DalinYYYY/JM-App/User/DataHub/version_readme.md

# 版本记录

> 版本号定义见 `User/DataHub/version.h`。每次主仓库提交递增 `APP_VERSION_PATCH`，并在下表追加对应条目。

| 版本 | 日期 | 类型 | 备注 |
| --- | --- | --- | --- |
| 1.0.0 | 2026-09-18 | baseline | 现有基线版本发布 |
