DalinYYYY/JM-App/User/Data/picture/重构后过渡模块边界图.jpg

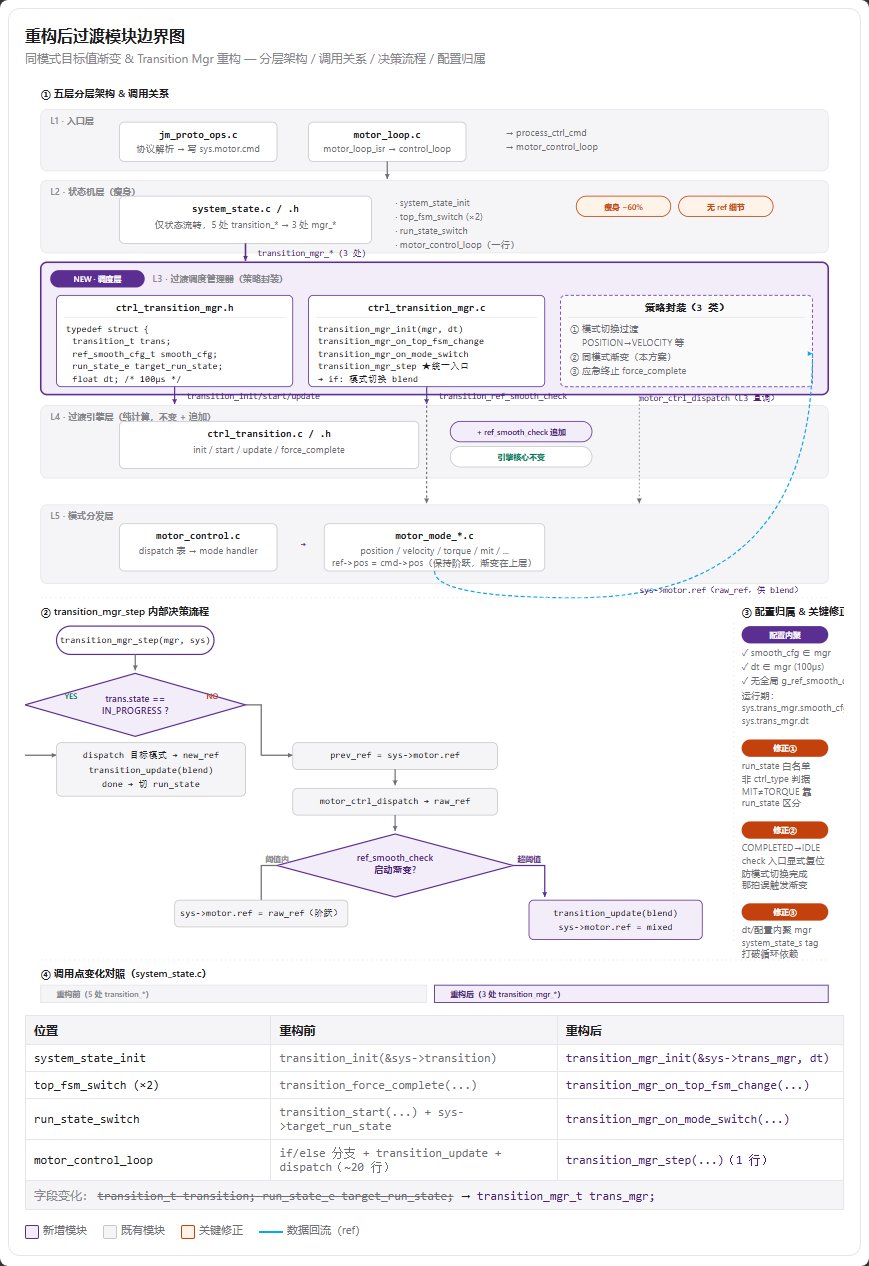
User/Data/picture/重构后过渡模块边界图.jpg
