DalinYYYY/JM-App/User/MotorAlgorithms/docs/开环速度观测对比.jpg

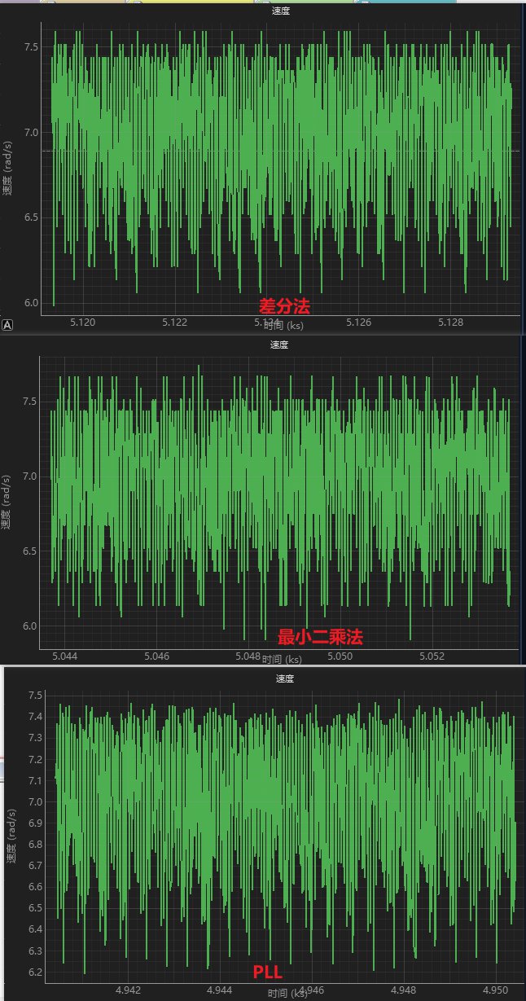
User/MotorAlgorithms/docs/开环速度观测对比.jpg
