DalinYYYY/JM-App/User/Data/docs/SCH_FOC_SCH_V1.0_2026-07-20.pdf

框架：

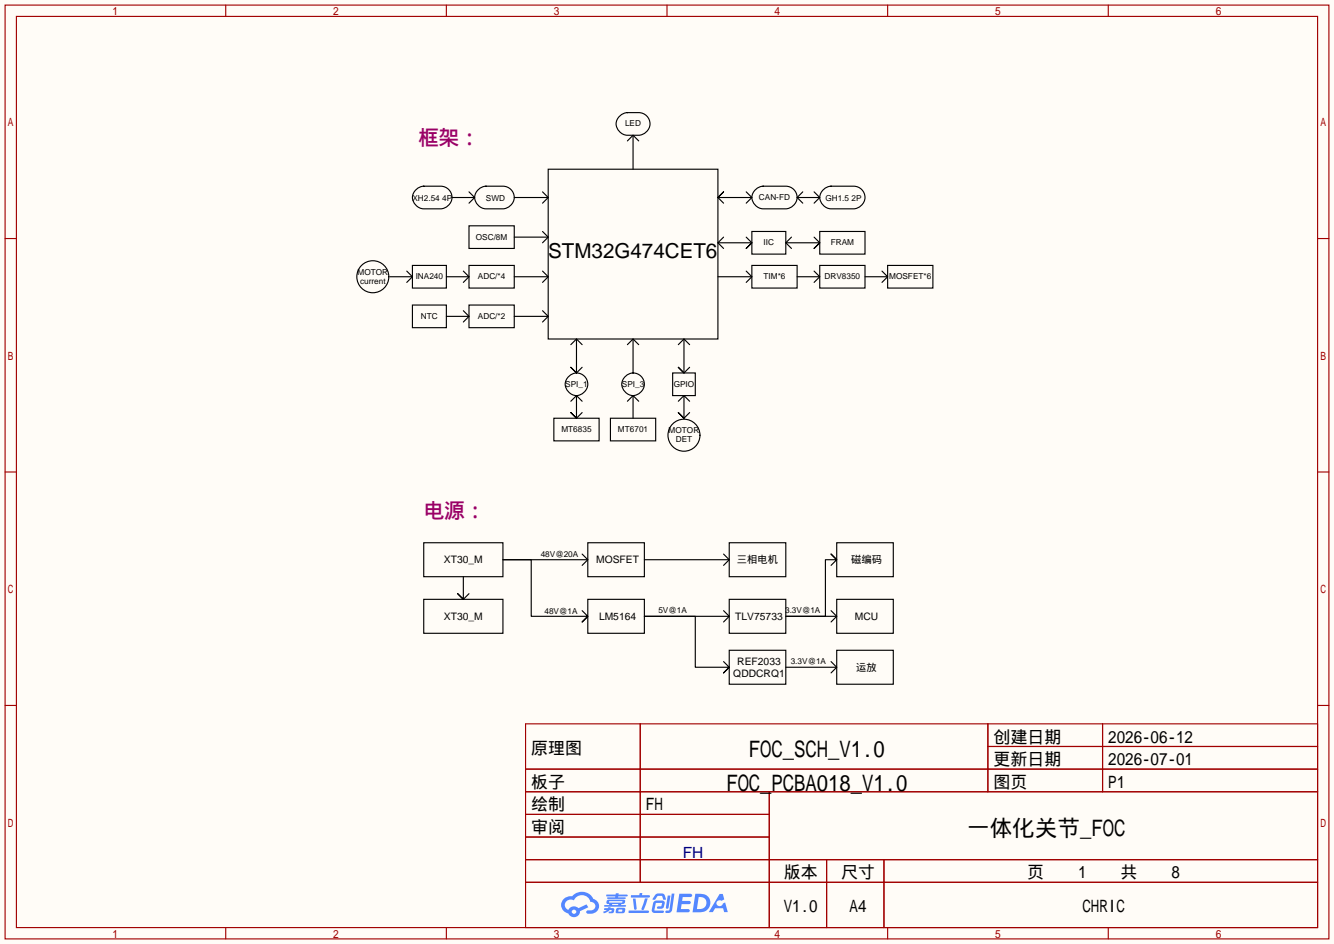
[picture p7: page 1]

原理图 | FOC_SCH_V1.0 | 创建日期 | 2026-06-12
板子 | FOC_PCBA018_V1.0 | 图页 | P1
绘制 | FH | 一体化关节_FOC
审阅

更新日期 | 2026-07-01

V1.0 | A4 | CHRIC

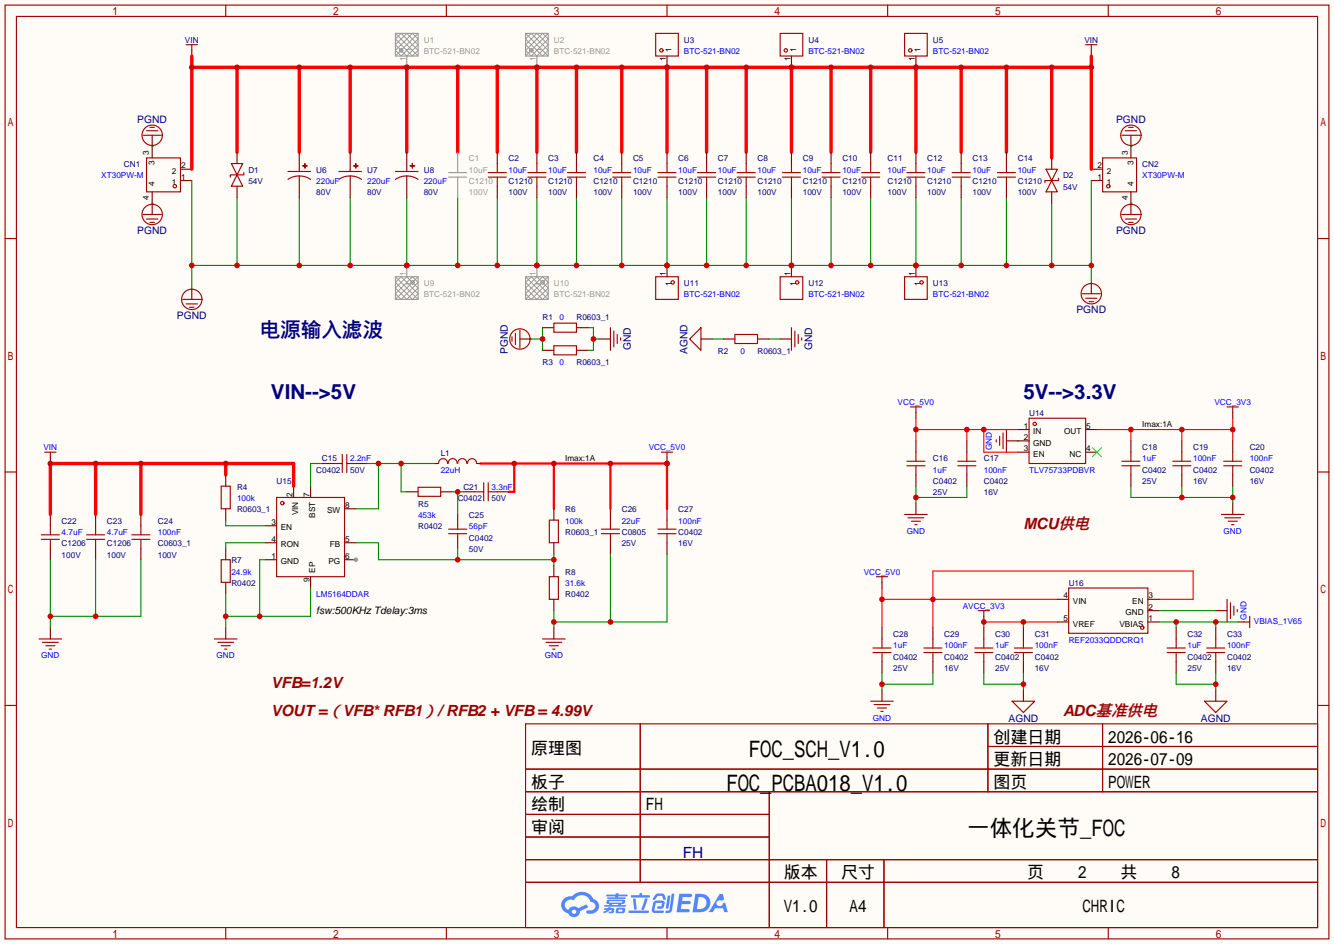
[picture p8: page 2]

原理图 | FOC_SCH_V1.0 | 创建日期 | 2026-06-16
板子 | FOC_PCBA018_V1.0 | 图页 | POWER
绘制 | FH | 一体化关节_FOC
审阅

更新日期 | 2026-07-09

晶振 | MCU | LED

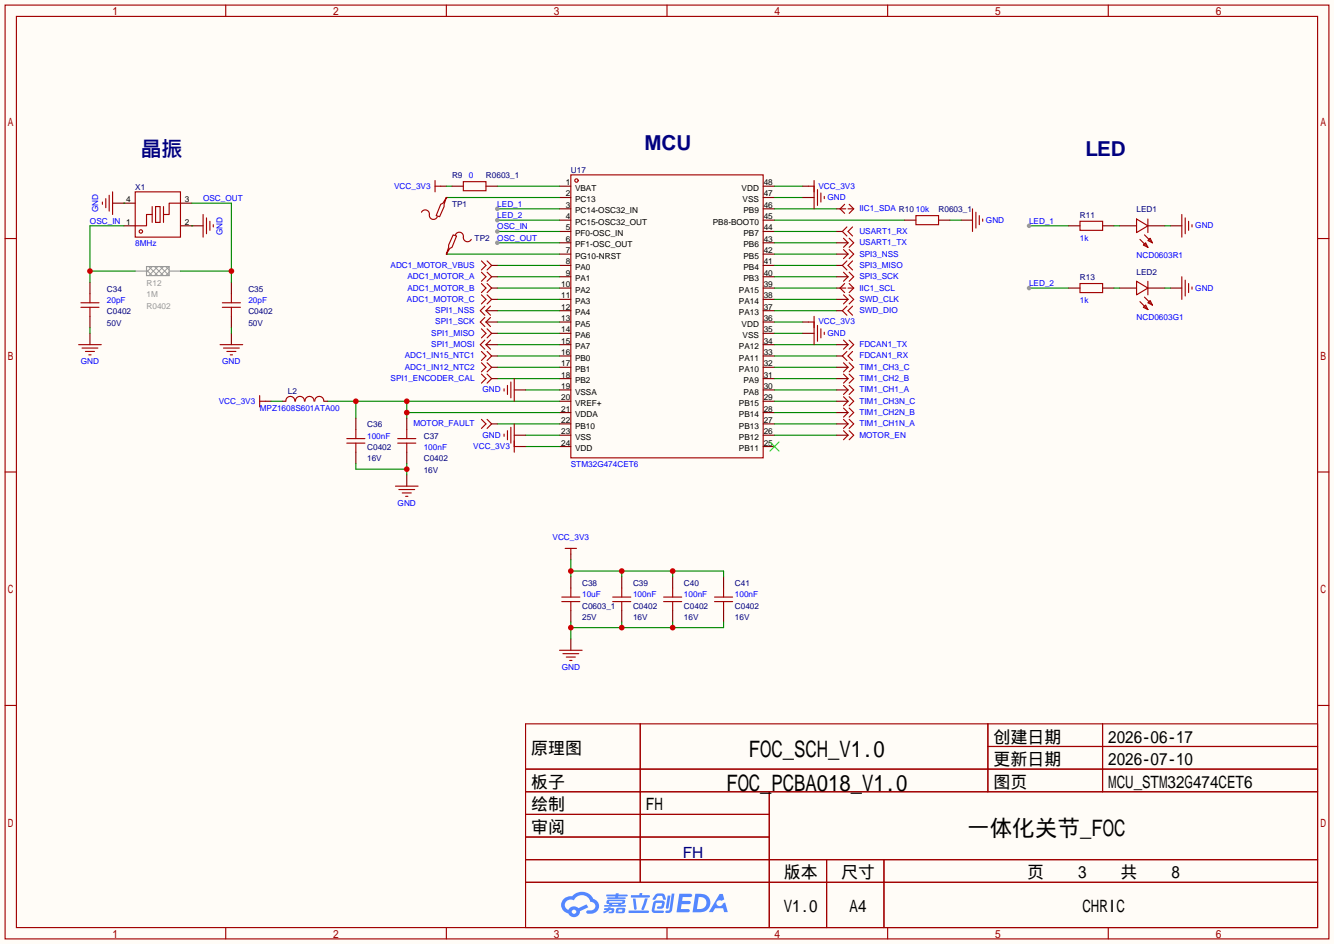
[picture p9: page 3]

原理图 | FOC_SCH_V1.0 | 创建日期 | 2026-06-17

更新日期 | 2026-07-10

板子 | FOC_PCBA018_V1.0 | 图页 | MCU_STM32G474CET6
绘制 | FH | 一体化关节_FOC
审阅

主编码 | 副编码

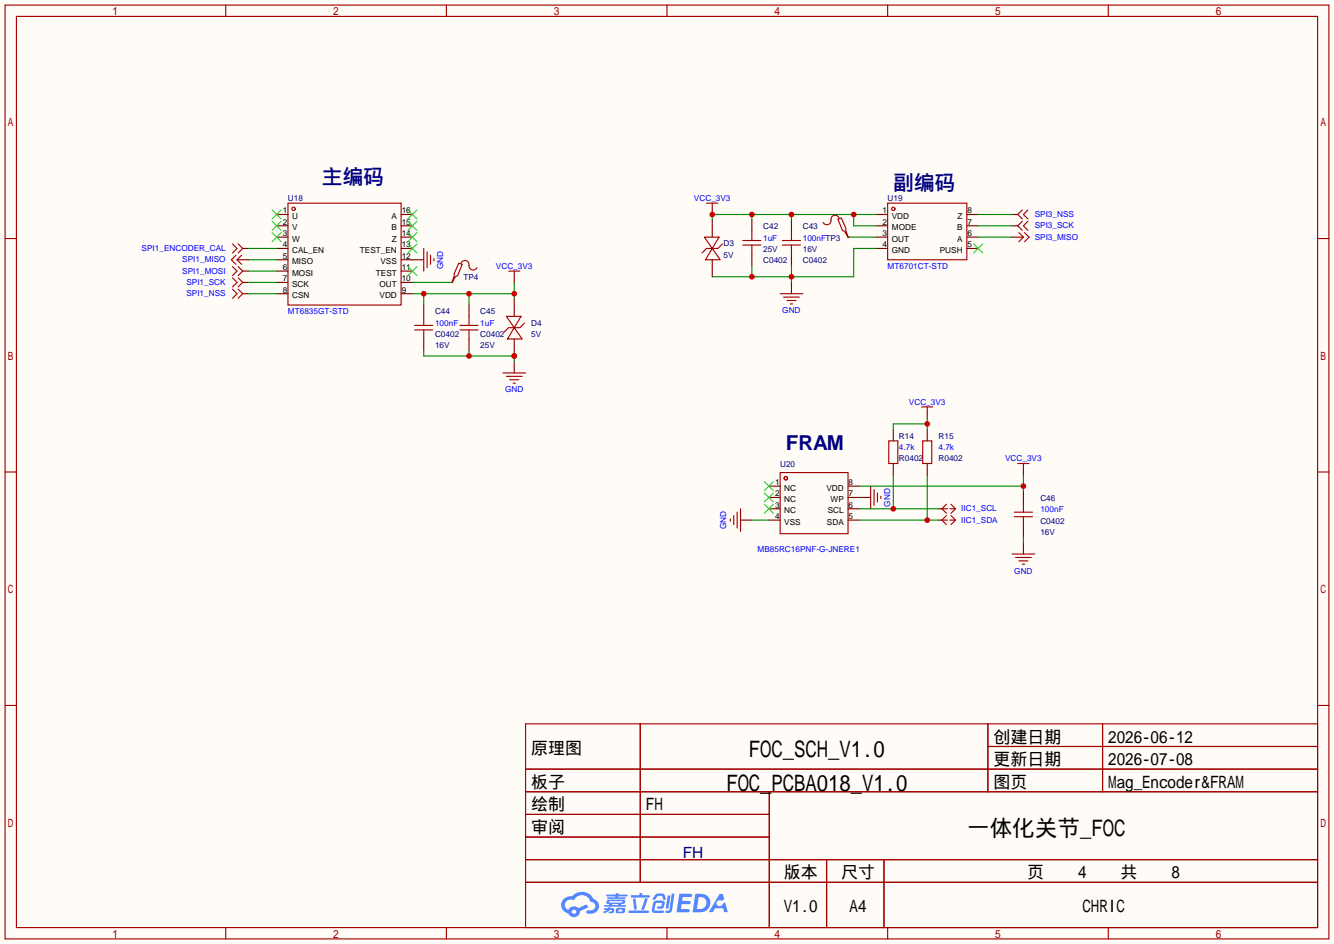
[picture p10: page 4]

原理图 | FOC_SCH_V1.0 | 创建日期 | 2026-06-12

更新日期 | 2026-07-08

板子 | FOC_PCBA018_V1.0 | 图页 | Mag_Encoder&FRAM
绘制 | FH | 一体化关节_FOC
审阅

# 三相驱动

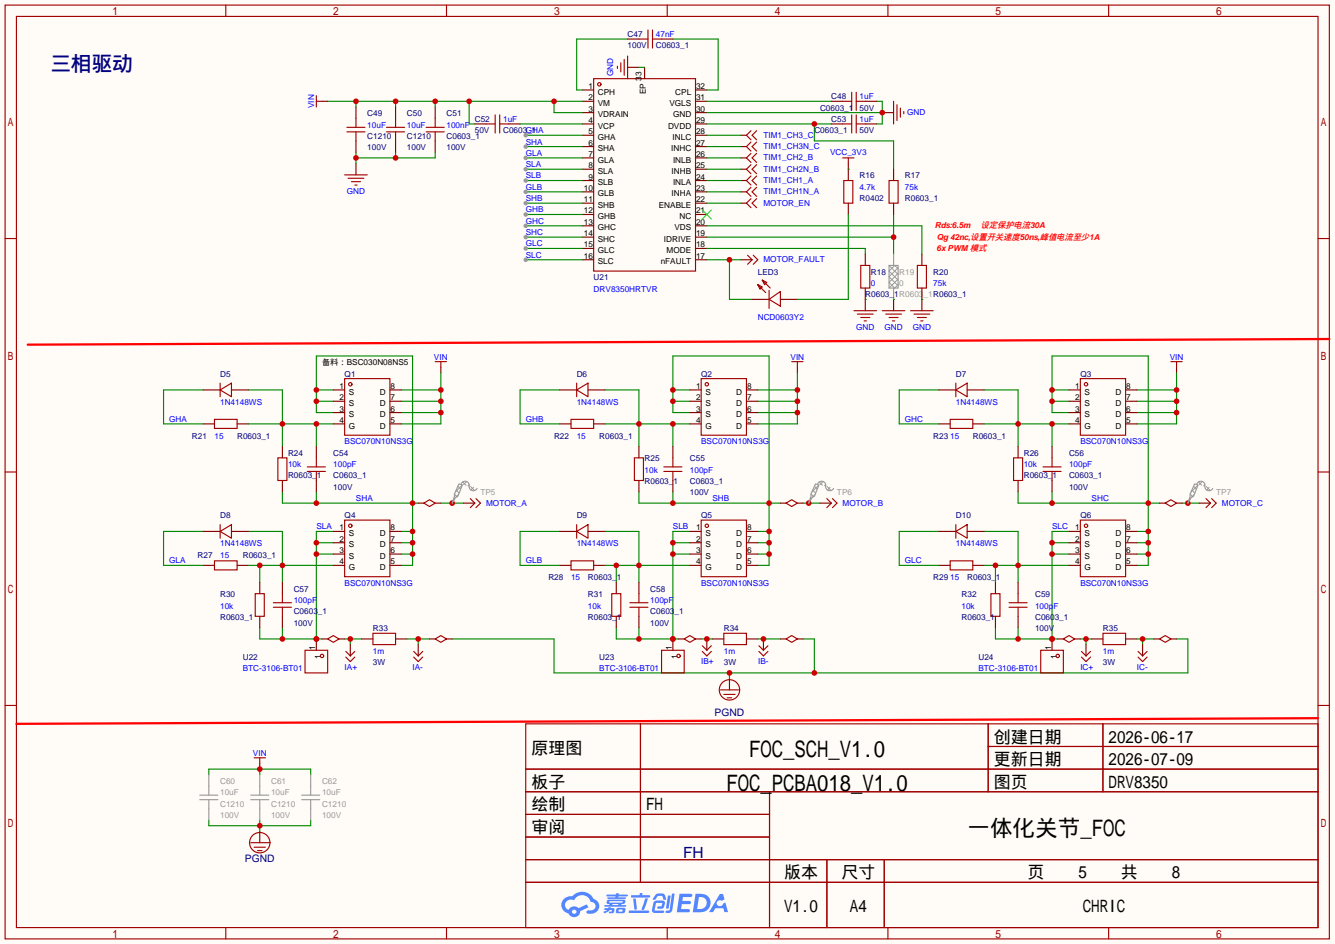
[picture p11: page 5]

原理图 | FOC_SCH_V1.0 | 创建日期 | 2026-06-17
板子 | FOC_PCBA018_V1.0 | 图页 | DRV8350
绘制 | FH | 一体化关节_FOC
审阅

更新日期 | 2026-07-09

# CAN隔离收发

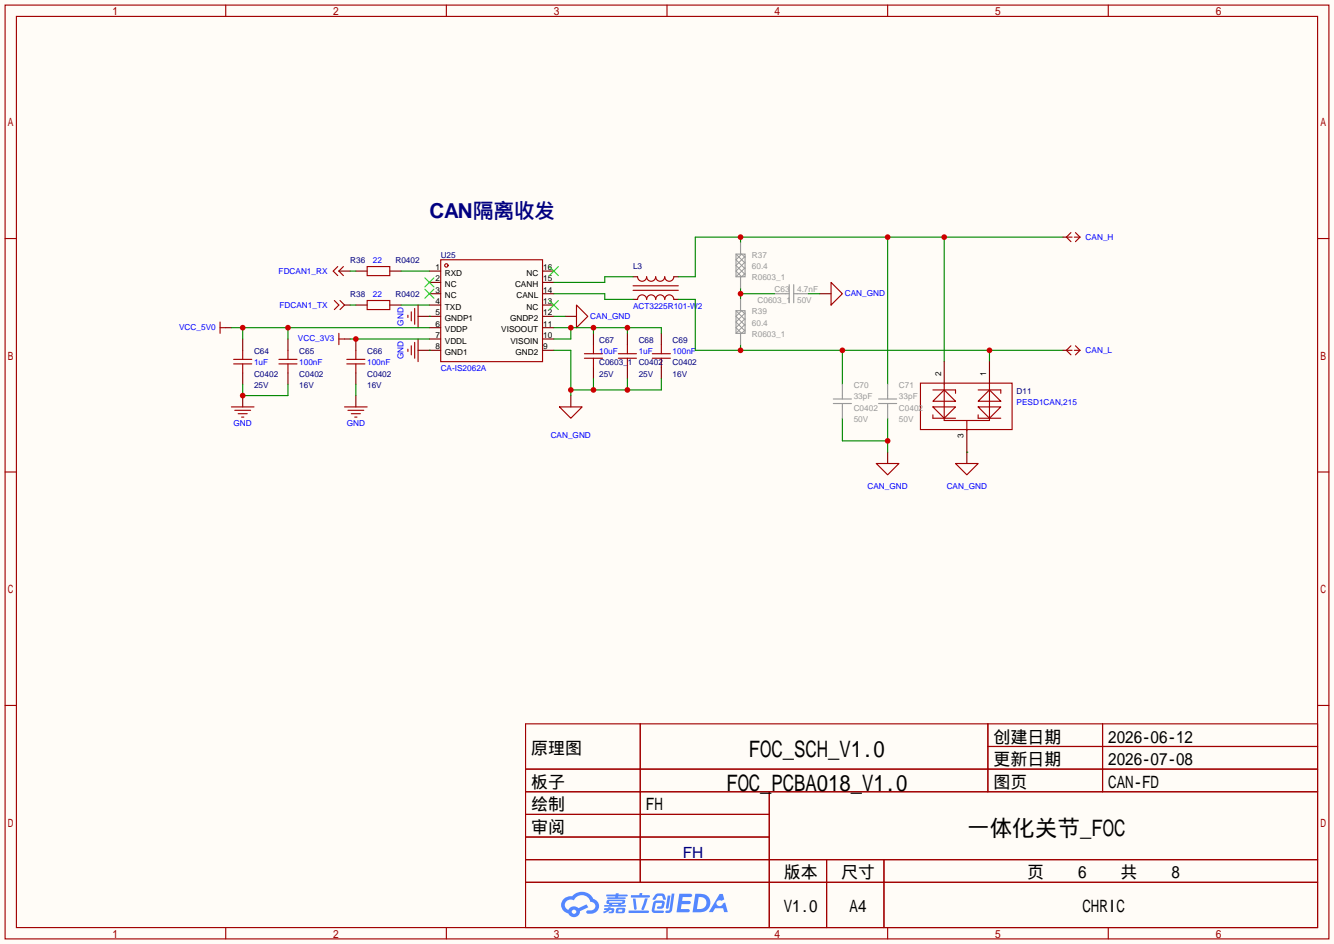
[picture p12: page 6]

VISOIN 10 VISOOUT 11 GNDP2 12 NC 13 CANL 14 CANH 15 NC 16

原理图 | FOC_SCH_V1.0 | 创建日期 | 2026-06-12
板子 | FOC_PCBA018_V1.0 | 图页 | CAN-FD
绘制 | FH | 一体化关节_FOC
审阅

更新日期 | 2026-07-08

差分放大 | 电流采样计算

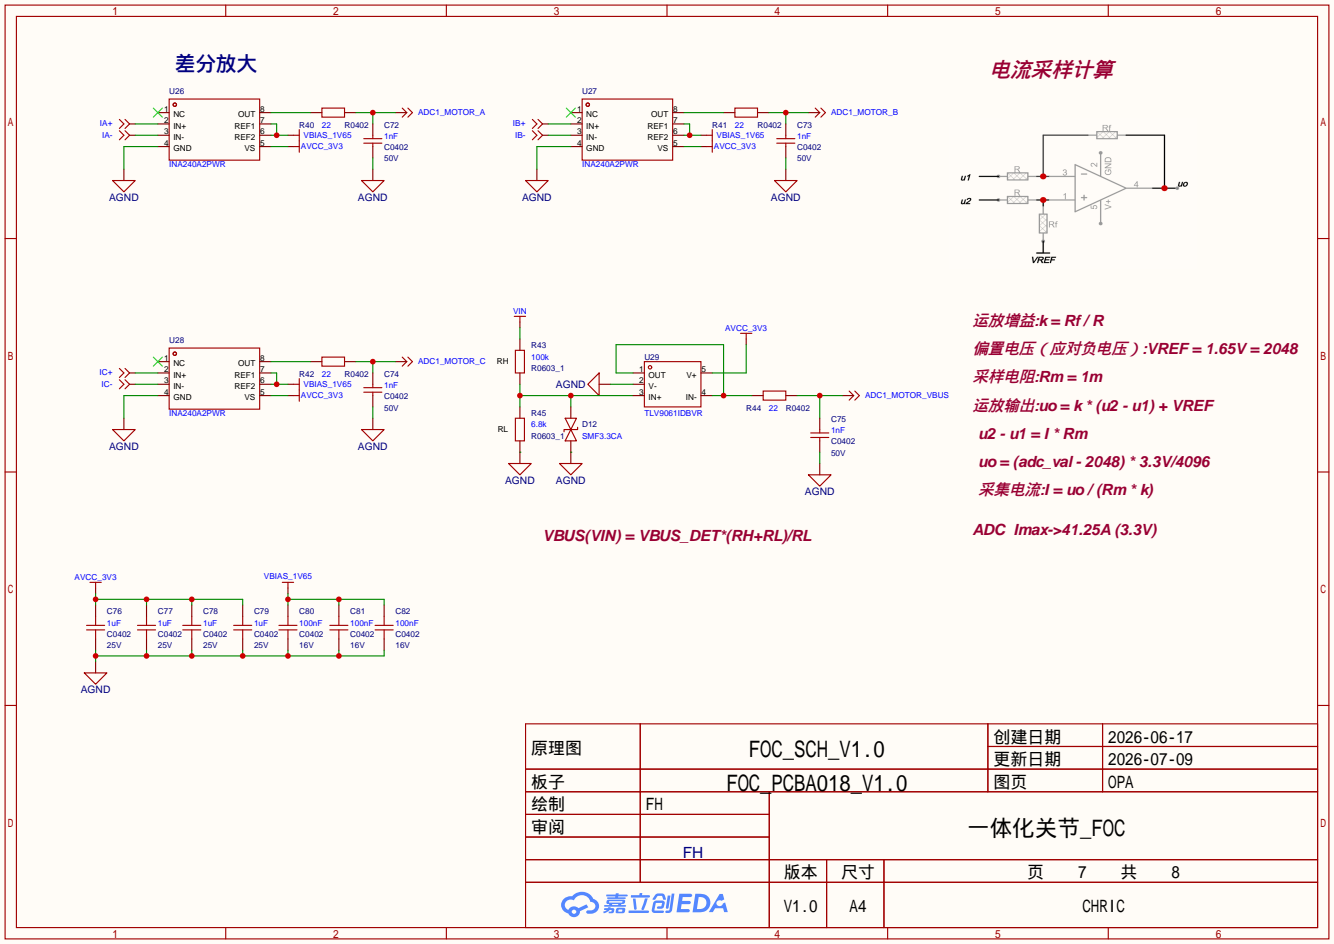
[picture p13: page 7]

ADC Imax->41.25A (3.3V) VBUS(VIN) = VBUS_DET*(RH+RL)/RL

原理图 | FOC_SCH_V1.0 | 创建日期 | 2026-06-17
板子 | FOC_PCBA018_V1.0 | 图页 | OPA
绘制 | FH | 一体化关节_FOC
审阅

更新日期 | 2026-07-09

温度采样 | CAN接口

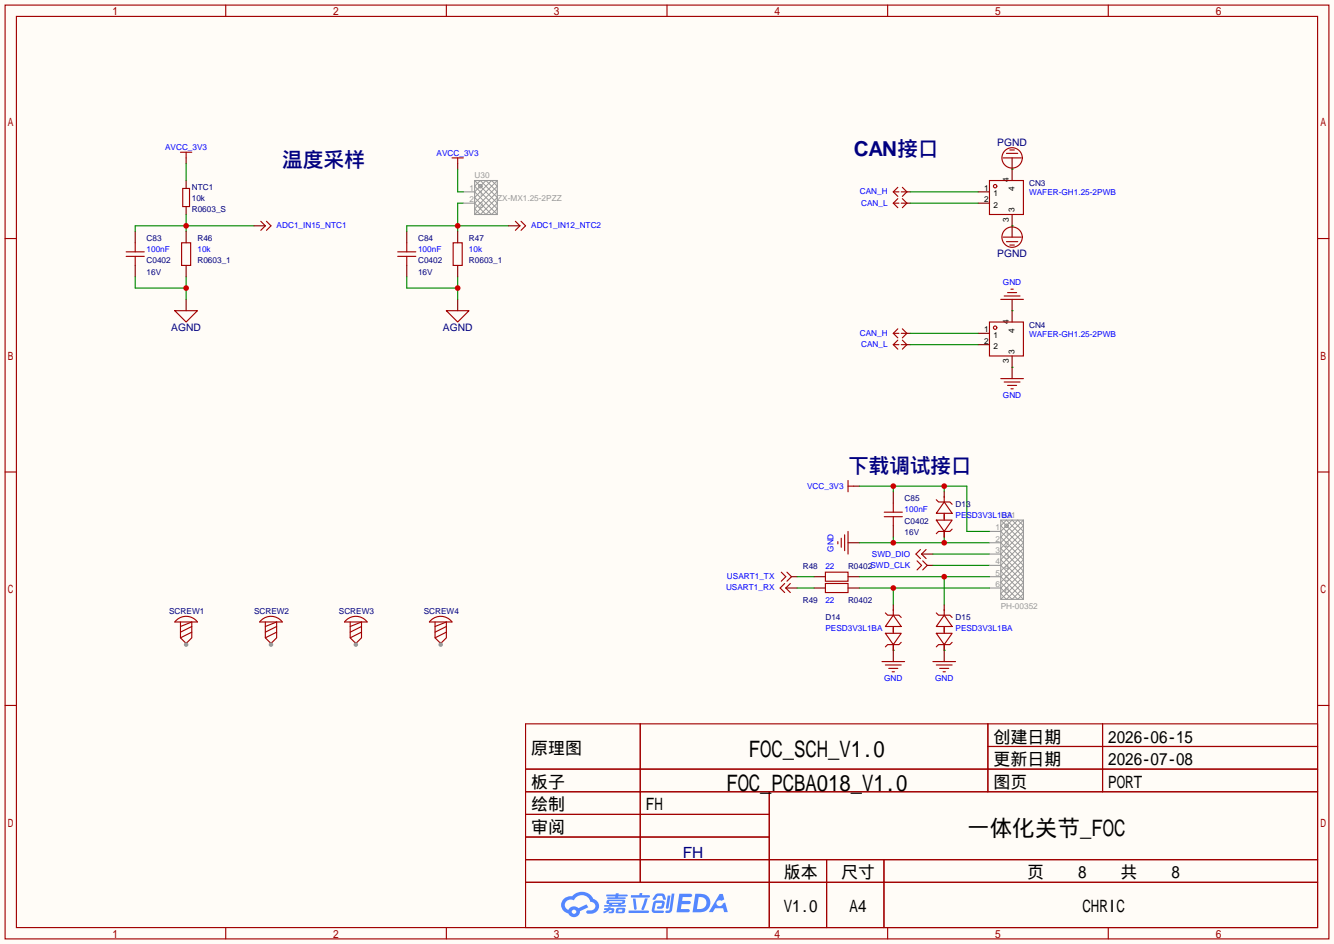
[picture p14: page 8]

原理图 | FOC_SCH_V1.0 | 创建日期 | 2026-06-15
板子 | FOC_PCBA018_V1.0 | 图页 | PORT
绘制 | FH | 一体化关节_FOC
审阅

更新日期 | 2026-07-08
