DalinYYYY/JM-App/User/AppServices/StateMachine/system_state.c

/**
 * @file        system_state.c
 * @brief 系统状态机实现文件
 * @details 仅负责状态管理：顶层主状态机表驱动转移 + 进入/退出动作，
 *          控制逻辑(参考生成)经 motor_ctrl_dispatch 调用，本文件不含。
 *
 * @author      yangsl (yangsl@robot.com)
 * @version     1.1
 * @date        2026-06-11
 *
 * @copyright   Copyright (c) 2026 RuidiculousTech.co, Ltd. All rights reserved.
 *
 * @par 修改日志:
 * | 日期       | 版本 | 作者   | 修改内容                              |
 * |------------|------|--------|---------------------------------------|
 * | 2026-06-11 | 1.0  | yangsl | 初始创建                              |
 * | 2026-06-12 | 1.1  | yangsl | 加 READY 态/转移许可表，剥离控制逻辑  |
 *
 * @note        本文件遵循《嵌入式C代码规范V1.0》开发
 */

#include "system_state.h"
#include "calib_mgr.h"
#include "fault_manager.h"
#include "motor_mode.h" /* motor_load_sim_reset: 负载模拟模式进入复位 */
#include "dev_dwt_counter.h" /* ISR 分段耗时打点(调试期) */
#include "runtime_param.h"   /* SYS_TIMER_RECORD_ 打点索引 */
#include "cogging_comp.h" /* 齿槽表落盘互锁: 本文件包含链不经 dev_config.h,
                           * 须先无条件包含本头(其内部先含 dev_config.h 使
                           * USE_DEV_FLASH 可见, 再自我门控), 守卫才有效 */
#include <string.h>

/**
 * @brief 运行模式平滑过渡的调用次数（rate 不适用时的兜底时长）
 * @details 过渡时长以 motor_control_loop（建议置于电流环）的调用次数计，
 *          而非软件定时器。可在运行期配置：调用次数 = 期望过渡时长 / 电流环周期。
 *          例：电流环 50us，期望过渡 5ms，则置为 100。
 *          注意：smooth_cfg 任一 rate>0 时模式切换过渡首拍会按速率重算时长，
 *          覆盖此值（=|Δ目标|/rate）；rate 全<=0 时才使用此固定时长。
 */
uint32_t g_run_state_trans_count = 1000;

/**
 * @brief 控制指令到运行状态的映射表
 * @details 上层运动控制指令（ctrl_mode_e）到底层运行状态（run_state_e）的映射。
 */
static const run_state_e s_ctrl_mode_to_run_state[CONTROL_MODE_MAX] = {
	[CONTROL_MODE_IDLE] = RUN_STATE_IDLE,
	[CONTROL_MODE_HOLD] = RUN_STATE_HOLD,
	[CONTROL_MODE_BRAKE] = RUN_STATE_HOLD, /* 刹车=位置保持 */

	[CONTROL_MODE_OPEN_LOOP] = RUN_STATE_OPEN_LOOP,
	[CONTROL_MODE_CURRENT] = RUN_STATE_CURRENT,
	[CONTROL_MODE_TORQUE] = RUN_STATE_TORQUE,
	[CONTROL_MODE_MIT] = RUN_STATE_MIT,
	[CONTROL_MODE_VELOCITY] = RUN_STATE_VELOCITY,
	[CONTROL_MODE_POSITION] = RUN_STATE_POSITION,
	[CONTROL_MODE_POSITION_VELOCITY] = RUN_STATE_POSITION_VELOCITY,
	[CONTROL_MODE_POSITION_TORQUE] = RUN_STATE_POSITION_TORQUE,
	[CONTROL_MODE_VELOCITY_TORQUE] = RUN_STATE_VELOCITY_TORQUE,
	[CONTROL_MODE_DUTY_CYCLE] = RUN_STATE_DUTY_CYCLE,
	[CONTROL_MODE_VOLTAGE_VECTOR] = RUN_STATE_VOLTAGE_VECTOR,
	[CONTROL_MODE_FIELD_WEAKENING] = RUN_STATE_FIELD_WEAKENING,
	[CONTROL_MODE_SENSORLESS] = RUN_STATE_SENSORLESS,

	[CONTROL_MODE_IMPEDANCE] = RUN_STATE_IMPEDANCE,
	[CONTROL_MODE_ADMITTANCE] = RUN_STATE_ADMITTANCE,
	[CONTROL_MODE_FORCE_CONTROL] = RUN_STATE_FORCE_CONTROL,
	[CONTROL_MODE_FORCE_POSITION_HYBRID] = RUN_STATE_FORCE_POSITION_HYBRID,
	[CONTROL_MODE_GRAVITY_COMPENSATION] = RUN_STATE_GRAVITY_COMPENSATION,
	[CONTROL_MODE_COLLISION_DETECTION] = RUN_STATE_COLLISION_DETECTION,
	[CONTROL_MODE_ZERO_FORCE] = RUN_STATE_ZERO_FORCE,
	[CONTROL_MODE_CONSTANT_FORCE] = RUN_STATE_CONSTANT_FORCE,
	[CONTROL_MODE_VARIABLE_IMPEDANCE] = RUN_STATE_VARIABLE_IMPEDANCE,
	[CONTROL_MODE_ADAPTIVE_GRAVITY_COMP] = RUN_STATE_ADAPTIVE_GRAVITY_COMP,
	[CONTROL_MODE_LANDING_BUFFER] = RUN_STATE_LANDING_BUFFER,

	[CONTROL_MODE_PVT] = RUN_STATE_PVT,
	[CONTROL_MODE_CUBIC_SPLINE] = RUN_STATE_CUBIC_SPLINE,
	[CONTROL_MODE_TRAPEZOIDAL_TRAJ] = RUN_STATE_TRAPEZOIDAL_TRAJ,
	[CONTROL_MODE_S_CURVE_TRAJ] = RUN_STATE_S_CURVE_TRAJ,
	[CONTROL_MODE_HOMING] = RUN_STATE_HOMING,
	[CONTROL_MODE_CANOPEN_SYNC] = RUN_STATE_POSITION, /* SYNC 同步位置 */
	[CONTROL_MODE_ETHERCAT_CSP] = RUN_STATE_POSITION, /* CSP = Cyclic Sync Position */
	[CONTROL_MODE_ETHERCAT_CSV] = RUN_STATE_VELOCITY, /* CSV = Cyclic Sync Velocity */
	[CONTROL_MODE_ETHERCAT_CST] = RUN_STATE_TORQUE,   /* CST = Cyclic Sync Torque */
	[CONTROL_MODE_PP] = RUN_STATE_POSITION,           /* Profile Position（前期复用 POSITION）*/
	[CONTROL_MODE_PV] = RUN_STATE_PROFILE_VELOCITY,   /* Profile Velocity → 独立模式文件 */
	[CONTROL_MODE_PT] = RUN_STATE_PROFILE_TORQUE,     /* Profile Torque → 独立模式文件 */
	[CONTROL_MODE_ELECTRONIC_GEAR] = RUN_STATE_ELECTRONIC_GEAR,
	[CONTROL_MODE_ELECTRONIC_CAM] = RUN_STATE_ELECTRONIC_CAM,

	[CONTROL_MODE_PASSIVE_TORQUE] = RUN_STATE_PASSIVE_TORQUE,
	[CONTROL_MODE_DYNAMIC_TORQUE] = RUN_STATE_DYNAMIC_TORQUE,
	[CONTROL_MODE_QUADRATIC_LOAD] = RUN_STATE_QUADRATIC_LOAD,
	[CONTROL_MODE_CONSTANT_POWER] = RUN_STATE_CONSTANT_POWER,
	[CONTROL_MODE_FRICTION_LOAD] = RUN_STATE_FRICTION_LOAD,
	[CONTROL_MODE_INERTIA_SIM] = RUN_STATE_INERTIA_SIM,
	[CONTROL_MODE_DUTY_PROFILE] = RUN_STATE_DUTY_PROFILE,
	[CONTROL_MODE_IMPACT_LOAD] = RUN_STATE_IMPACT_LOAD,

	[CONTROL_MODE_STEP_DIR] = RUN_STATE_STEP_DIR,
	[CONTROL_MODE_ANALOG_INPUT] = RUN_STATE_ANALOG_INPUT,
	[CONTROL_MODE_PWM_INPUT] = RUN_STATE_PWM_INPUT,
	[CONTROL_MODE_JOG] = RUN_STATE_JOG,
	[CONTROL_MODE_SAFE_TEACH] = RUN_STATE_SAFE_TEACH,

	[CONTROL_MODE_TEST_AGING] = RUN_STATE_TEST_AGING,
	[CONTROL_MODE_TEST_SWEEP_FREQ] = RUN_STATE_TEST_SWEEP_FREQ,
	[CONTROL_MODE_TEST_COGGING] = RUN_STATE_TEST_COGGING,
	[CONTROL_MODE_TEST_FRICTION] = RUN_STATE_TEST_FRICTION,
	[CONTROL_MODE_TEST_INERTIA] = RUN_STATE_TEST_INERTIA,
	[CONTROL_MODE_DIAGNOSTIC] = RUN_STATE_DIAGNOSTIC,
	[CONTROL_MODE_HIGH_SPEED_DAQ] = RUN_STATE_HIGH_SPEED_DAQ,
	[CONTROL_MODE_SINGLE_STEP] = RUN_STATE_SINGLE_STEP,
};

/**
 * @brief 顶层状态转移许可表
 * @details 表驱动的状态机：s_top_fsm_allowed[from][to] 为 true 表示允许该转移。
 *          FAULT/SAFETY 作为最高优先级，可从任意状态进入（在判断函数中单独处理）。
 *          对照状态机图核对/修改本表即可调整全部转移规则。
 *  
 *          转移逻辑：
 *            INIT  → IDLE
 *            IDLE  → READY / CALIB / CONFIG / BOOTLOADER
 *            READY → RUN / IDLE
 *            RUN   → READY            （停止运行后回就绪，再回 IDLE 下使能）
 *            FAULT → IDLE             （清除故障）
 *            SAFETY→ IDLE             （解除急停）
 *            CALIB → IDLE
 *            CONFIG→ IDLE
 *            BOOTLOADER→ IDLE
 */
static const bool s_top_fsm_allowed[TOP_FSM_MAX][TOP_FSM_MAX] = {
	[TOP_FSM_INIT] = {[TOP_FSM_IDLE] = true},
	[TOP_FSM_IDLE] = {[TOP_FSM_READY] = true, [TOP_FSM_CALIB] = true, [TOP_FSM_CONFIG] = true, [TOP_FSM_BOOTLOADER] = true},
	[TOP_FSM_READY] = {[TOP_FSM_RUN] = true, [TOP_FSM_IDLE] = true, [TOP_FSM_CALIB] = true},
	[TOP_FSM_RUN] = {[TOP_FSM_READY] = true},
	[TOP_FSM_FAULT] = {[TOP_FSM_IDLE] = true},
	[TOP_FSM_SAFETY] = {[TOP_FSM_IDLE] = true},
	[TOP_FSM_CALIB] = {[TOP_FSM_IDLE] = true},
	[TOP_FSM_CONFIG] = {[TOP_FSM_IDLE] = true},
	[TOP_FSM_BOOTLOADER] = {[TOP_FSM_IDLE] = true},
};

/**
 * @brief 判断顶层状态转移是否合法
 * @param from 源状态
 * @param to 目标状态
 * @return true 允许 / false 禁止
 * @note FAULT 与 SAFETY 可从任意状态进入（最高优先级），不受许可表限制。
 */
static bool top_fsm_transition_allowed(top_fsm_e from, top_fsm_e to)
{
	if (to >= TOP_FSM_MAX || from >= TOP_FSM_MAX)
		return false;

	// 故障/安全：任意状态可进入
	if (to == TOP_FSM_FAULT || to == TOP_FSM_SAFETY)
		return true;

	return s_top_fsm_allowed[from][to];
}

/**
 * @brief 初始化系统状态机（具体实现）
 */
void system_state_init(system_state_t *sys, struct dev_motor *motor, motor_param_t *param, float dt)
{
	memset(sys, 0, sizeof(system_state_t));

	motor_ctrl_init(&sys->motor, param, dt);
	calib_mgr_init(motor, param, dt);
	transition_mgr_init(&sys->trans_mgr, dt);

	sys->top_state = TOP_FSM_INIT;
	sys->ctrl_mode = CONTROL_MODE_IDLE;
	sys->fault_code = 0;

	/* 故障管理器绑定状态机(检测/仲裁/动作统一委托, 消抖阈值按 dt 换算) */
	fault_mgr_attach(sys);

	top_fsm_switch(sys, TOP_FSM_IDLE);
}

/**
 * @brief 切换顶层有限状态机状态（具体实现）
 * @details 表驱动 + 进入/退出动作。非法转移直接拒绝。
 */
void top_fsm_switch(system_state_t *sys, top_fsm_e new_state)
{
	// 没有切换状态就直接返回
	if (new_state == sys->top_state)
		return;

	// 转移许可表校验
	if (!top_fsm_transition_allowed(sys->top_state, new_state))
		return;

	switch (sys->top_state)
	{
		case TOP_FSM_RUN:
			// 退出运行：停止参考输出，强制结束过渡
			sys->motor.ref.ctrl_type = REF_CTRL_IDLE;
			transition_mgr_on_top_fsm_change(&sys->trans_mgr, new_state);
			break;

		case TOP_FSM_CALIB:
			calib_mgr_abort();
			sys->calib_state = CALIB_STATE_IDLE;
			break;
		case TOP_FSM_CONFIG:
			break;

		default:
			break;
	}

	/* ---- 进入动作（进入新状态的初始化）---- */
	switch (new_state)
	{
		case TOP_FSM_IDLE:
			// 待机：伺服失能，运行子状态归零
			sys->motor.run_state = RUN_STATE_IDLE;
			sys->motor.ref.ctrl_type = REF_CTRL_IDLE;
			break;

		case TOP_FSM_READY:
			// 就绪：已使能但不运动，运行子状态置空闲保持
			sys->motor.run_state = RUN_STATE_IDLE;
			sys->motor.ref.ctrl_type = REF_CTRL_IDLE;
			break;

		case TOP_FSM_FAULT:
		case TOP_FSM_SAFETY:
			// 故障/急停：立即失能输出
			sys->motor.ref.ctrl_type = REF_CTRL_IDLE;
			transition_mgr_on_top_fsm_change(&sys->trans_mgr, new_state);
			break;

		case TOP_FSM_CALIB:
			sys->calib_state = CALIB_STATE_IDLE;
			sys->motor.ref.ctrl_type = REF_CTRL_IDLE;
			break;

		default:
			break;
	}

	sys->top_state = new_state;
}

/**
 * @brief 切换电机运行状态（具体实现，仅在 RUN 态内有效）
 * @details 启动参考层平滑过渡
 */
void run_state_switch(system_state_t *sys, run_state_e new_state, uint32_t trans_count)
{
	if (new_state >= RUN_STATE_MAX)
		return;

	/* 切换过渡进行中：run_state 仍为旧值，判据改用 target_run_state。
	 * 目标相同=重复指令，忽略（重启过渡会使渐变斜率归零造成顿挫）；
	 * 目标不同（含切回旧模式）=从当前混合输出重启过渡 */
	if (sys->trans_mgr.trans.state == TRANSITION_IN_PROGRESS)
	{
		if (new_state == sys->trans_mgr.target_run_state)
			return;
	}
	else if (new_state == sys->motor.run_state)
	{
		return;
	}
	/* 扫频带有内部时序和 TRACE 点边界，不能在普通参考平滑过渡期间  */
	if (new_state == RUN_STATE_TEST_SWEEP_FREQ)
	{
		transition_force_complete(&sys->trans_mgr.trans);
		sys->trans_mgr.target_run_state = new_state;
		sys->motor.run_state = new_state;
		return;
	}

	/* 负载模拟模式: 过渡启动前复位运行时状态(相位/计时/加速度估计) */
	if (new_state >= RUN_STATE_PASSIVE_TORQUE && new_state <= RUN_STATE_IMPACT_LOAD)
		motor_load_sim_reset(&sys->motor);

	/* PV 速度轮廓: 复位斜坡状态, 下拍从实测速度无扰起步 */
	if (new_state == RUN_STATE_PROFILE_VELOCITY)
		motor_profile_vel_reset(&sys->motor);

	transition_mgr_on_mode_switch(&sys->trans_mgr, new_state, trans_count, &sys->motor.ref);
}

/**
 * @brief 电机控制主循环（具体实现）
 * @details 仅 RUN 态生成运动参考；其余状态参考保持 IDLE。
 *          控制逻辑（参考生成）经 motor_ctrl_dispatch 调用，本文件不含。
 */
void motor_control_loop(system_state_t *sys, bool fault_tick)
{
	/* 故障保护必须位于参考生成之前；扫频在本周期不得再产生新的激励。 */
	fault_check(sys, fault_tick);
	if (sys->top_state == TOP_FSM_FAULT || sys->top_state == TOP_FSM_SAFETY)
	{
		sys->motor.ref.ctrl_type = REF_CTRL_IDLE;
		return;
	}
	/* CALIB 态：周期推进标定，不生成运动参考 */
	if (sys->top_state == TOP_FSM_CALIB)
	{
		sys->calib_state = calib_mgr_poll();
		sys->motor.ref.ctrl_type = REF_CTRL_IDLE;
		return;
	}

	// 非运行态：失能输出，不生成运动参考
	if (sys->top_state != TOP_FSM_RUN)
	{
		sys->motor.ref.ctrl_type = REF_CTRL_IDLE;
		return;
	}

	// 运行态：所有过渡策略收敛到 transition_mgr_step
	transition_mgr_step(&sys->trans_mgr, sys);
	if (sys->motor.run_state == RUN_STATE_TEST_SWEEP_FREQ && motor_sweep_is_complete(&sys->motor) && sys->motor.sweep_finish_pending == 0u)
	{
		sys->motor.ref.ctrl_type = REF_CTRL_IDLE;
		top_fsm_switch(sys, TOP_FSM_READY);
	}
}

/**
 * @brief 系统故障检测（委托故障管理器）
 * @details 检测/记录/仲裁/级别动作统一在 fault_mgr_poll_fast 内完成
 *          (电气类快检测 + 停机类故障切 FAULT 态)。错峰调度:
 *          NaN 发散检测(fault_detect_diverge)每拍执行, 保护本拍算法输出;
 *          全量电气检测仅在 fault_tick 拍(1kHz)执行, 消抖阈值已按
 *          采样周期(控制周期×FAULT_DET_FAST_DIV)等效换算, 响应时间不变。
 *          本函数保留:
 *          1. 同步兼容字段到 sys(fault_code/fault_latched 等旧路径);
 *          2. 扫频中止与失能输出兜底(fault_mgr 不依赖 sweep 模块)。
 */
void fault_check(system_state_t *sys, bool fault_tick)
{
	if (sys == NULL || sys->motor.param == NULL)
		return;

	/* NaN 发散检测每拍(编译开关关闭时为空实现) */
	fault_detect_diverge(&g_fault_mgr);

	if (fault_tick)
	{
		dev_dwt_counter_start(SYS_TIMER_RECORD_FAULT_DET); /* 分段耗时: 全量电气检测 */
		fault_mgr_poll_fast();
		dev_dwt_counter_stop(SYS_TIMER_RECORD_FAULT_DET);
	}
	fault_mgr_sync_compat(sys);

	if (sys->fault_code != 0u)
	{
		motor_sweep_abort(&sys->motor);
		sys->motor.ref.ctrl_type = REF_CTRL_IDLE;
		top_fsm_switch(sys, TOP_FSM_FAULT);
	}
}

/**
 * @brief 齿槽表落盘互锁: 表待写/擦写期间(s_write_state==1)为真
 * @note L5.1 标定完成后表由 idle 线程异步擦写 Flash(drv_flash_write 全程
 *      关中断 10~40ms)。该期间进入 RUN(闭环带功率)或带电压标定, 擦写会
 *      冻结控制中断, PWM 停在非零占空比导致电流失控, 故在状态机唯一
 *      入口(process_ctrl_cmd)阻断, idle 线程落盘完成后自动放行(重发即可)。
 *      READY 不阻断: 电流环每拍把 PWM 驱到零, 擦写安全;
 *      已在 CALIB 态连续标定不阻断: idle 线程门控在 CALIB 态不落盘。
 */
static bool cogging_flush_busy(void)
{
#if defined(USE_DEV_FLASH)
	return cogging_comp_get_write_state() == 1u;
#else
	return false;
#endif
}

/**
 * @brief 处理上层控制指令（具体实现）
 * @details 指令分发与状态切换，三段式使能流程：
 *            IDLE --ENABLE--> READY --运动指令--> RUN
 *            RUN  --STOP----> READY --DISABLE--> IDLE
 *          系统指令（IDLE/ENABLE/DISABLE/STOP/ESTOP/BOOTLOADER等）单独处理；
 *          运动指令仅在 READY/RUN 态被接受，经映射表转为运行子状态。
 */
void process_ctrl_cmd(system_state_t *sys, ctrl_mode_e cmd)
{
	if (cmd >= CONTROL_MODE_MAX)
		return;

	/* ---- 急停：任意状态最高优先级响应 ---- */
	if (cmd == CONTROL_MODE_ESTOP)
	{
		sys->ctrl_mode = cmd;
		top_fsm_switch(sys, TOP_FSM_SAFETY);
		return;
	}

	/* ---- STOP 延迟过渡期间：拒绝其他命令（ESTOP 已上面处理）---- */
	if (sys->trans_mgr.stop_pending)
		return;

	/* ---- 故障态：仅响应清除故障 ---- */
	if (sys->top_state == TOP_FSM_FAULT)
	{
		if (cmd == CONTROL_MODE_CLEAR_FAULT)
		{
			/* 放行 fm 侧锁存记录: 条件已消失的清为 CLEARED, 仍触发的
			 * 下拍检测重新置 ACTIVE(与旧"条件消失才可清障"语义一致)。
			 * 无此步则 fault_code 恒派生自锁存记录, 清障死锁 */
			fault_mgr_clear(FAULT_CLEAR_LATCHED);
			fault_check(sys, true); /* 清障判定需立即全量检测, 不等错峰拍 */
			if (sys->fault_code == 0u)
			{
				sys->fault_latched = 0u;
				sys->ctrl_mode = cmd;
				top_fsm_switch(sys, TOP_FSM_IDLE);
			}
		}
		return;
	}

	/* ---- 安全态：仅响应清除故障（解除急停）---- */
	if (sys->top_state == TOP_FSM_SAFETY)
	{
		if (cmd == CONTROL_MODE_CLEAR_FAULT)
		{
			fault_mgr_clear(FAULT_CLEAR_LATCHED);
			fault_check(sys, true); /* 清障判定需立即全量检测, 不等错峰拍 */
			if (sys->fault_code == 0u)
			{
				sys->fault_latched = 0u;
				sys->ctrl_mode = cmd;
				top_fsm_switch(sys, TOP_FSM_IDLE);
			}
		}
		return;
	}

	/* ---- 系统级指令 ---- */
	switch (cmd)
	{
		case CONTROL_MODE_IDLE:
		case CONTROL_MODE_DISABLE:
			// 下使能：READY/RUN 经许可表逐级回到 IDLE
			if (sys->top_state == TOP_FSM_RUN)
				top_fsm_switch(sys, TOP_FSM_READY);

			top_fsm_switch(sys, TOP_FSM_IDLE);
			sys->ctrl_mode = cmd;
			return;

		case CONTROL_MODE_ENABLE:
			// 上使能：IDLE → READY
			/* DENY 类故障活动(低温等)时拒绝使能, 故障码经 0xAB 查询 */
			if (fault_mgr_deny_enable() != 0u)
				return;
			top_fsm_switch(sys, TOP_FSM_READY);
			if (sys->top_state == TOP_FSM_READY)
				sys->ctrl_mode = cmd;
			return;

		case CONTROL_MODE_STOP:
			/* 停止运行：RUN → READY（保持使能）
			 * 支持停机过渡的模式：启动延迟过渡，保持当前模式减速到零，完成后自动切 READY
			 * 不支持的模式（MIT/HOLD/直控）：立即切 READY */
			if (sys->top_state == TOP_FSM_RUN)
			{
				sys->ctrl_mode = cmd;
				if (!transition_mgr_on_stop(&sys->trans_mgr, sys))
					top_fsm_switch(sys, TOP_FSM_READY);
			}
			else if (sys->top_state == TOP_FSM_READY)
			{
				sys->ctrl_mode = cmd;
			}
			return;

		case CONTROL_MODE_ENTER_BOOTLOADER:
			top_fsm_switch(sys, TOP_FSM_BOOTLOADER);
			if (sys->top_state == TOP_FSM_BOOTLOADER)
				sys->ctrl_mode = cmd;
			return;

			/* 校准指令：进入 CALIB 状态
			 * 0x90-0x96: 启动标定（子模式已由 app_set_mode 传给 calib_mgr）
			 * 0x97/0x98: 查询/中止，不切状态（app_set_mode 已处理并 return）*/
		case CONTROL_MODE_CALIB_LEVEL1:
		case CONTROL_MODE_CALIB_LEVEL2:
		case CONTROL_MODE_CALIB_LEVEL3:
		case CONTROL_MODE_CALIB_LEVEL4:
		case CONTROL_MODE_CALIB_LEVEL5:
		case CONTROL_MODE_CALIB_LEVEL6:
		case CONTROL_MODE_CALIB_LEVEL7:
			/* IDLE 或 READY 态可进入校准；RUN 态需先停止再标定 */
			if (sys->top_state == TOP_FSM_IDLE || sys->top_state == TOP_FSM_READY)
			{
				if (cogging_flush_busy())
				{
					/* 齿槽表待落盘: 回滚 calib_mgr_start, 待 idle 线程落盘
					 * 完成后重发(与状态切换失败的回滚路径一致) */
					calib_mgr_abort();
					return;
				}
				top_fsm_switch(sys, TOP_FSM_CALIB);
				if (sys->top_state == TOP_FSM_CALIB)
					sys->ctrl_mode = cmd;
				else
					calib_mgr_abort(); /* 状态切换失败，回滚标定避免卡死 */
			}
			else if (sys->top_state == TOP_FSM_CALIB)
			{
				/* 已在 CALIB 态：上一个标定已 DONE/FAILED，calib_mgr_start 已成功启动新标定，
				 * 直接接受即可，不得 abort（否则会终止刚启动的新标定）*/
				sys->ctrl_mode = cmd;
			}
			else
			{
				/* 非法状态（RUN/FAULT/SAFETY等），回滚 calib_mgr_start */
				calib_mgr_abort();
			}
			return;

		case CONTROL_MODE_CALIB_QUERY:
		case CONTROL_MODE_CALIB_ABORT:
			/* 查询/中止不切状态，app_set_mode 已处理 */
			return;

		case CONTROL_MODE_SAVE_CONFIG:
			sys->ctrl_mode = cmd;
			return;

		case CONTROL_MODE_FACTORY_RESET:
			sys->ctrl_mode = cmd;
			return;

		default:
			break;
	}

	/* ---- 运动控制指令：需已使能（READY 或 RUN）---- */
	if (sys->top_state == TOP_FSM_READY)
	{
		/* 齿槽表待落盘: 阻断进 RUN——擦写冻结控制中断会使非零 PWM 失控,
		 * 且新表尚未生效; idle 线程落盘完成后重发即可, 见 cogging_flush_busy */
		if (cogging_flush_busy())
			return;

		/* READY → RUN：首次进入也走平滑过渡，避免位置阶跃 */
		top_fsm_switch(sys, TOP_FSM_RUN);
		run_state_e target = s_ctrl_mode_to_run_state[cmd];

		/* 进入 RUN 前把 motor.ref 设为 IDLE（保持当前位置）作为过渡起点 */
		sys->motor.ref.ctrl_type = REF_CTRL_IDLE;
		sys->motor.ref.pos = sys->motor.fb.pos;
		sys->motor.ref.vel = 0.0f;
		sys->motor.ref.torque = 0.0f;

		run_state_switch(sys, target, g_run_state_trans_count);
		sys->ctrl_mode = cmd;
	}
	else if (sys->top_state == TOP_FSM_RUN)
	{
		/* 停机渐变中收到新运动指令：取消停机，新目标经渐变逻辑平滑接管
		 * （同模式：目标再变化重启渐变；不同模式：模式切换过渡）。
		 * 不取消则同模式指令被 apply_stop_cmd 吞掉，切模式的过渡
		 * 完成后会被残留 stop_pending 立即停机 */
		transition_mgr_cancel_stop(&sys->trans_mgr);

		// RUN 态内运动模式切换：走平滑过渡，时长由全局调用次数配置
		run_state_e target = s_ctrl_mode_to_run_state[cmd];
		run_state_switch(sys, target, g_run_state_trans_count);
		sys->ctrl_mode = cmd;
	}
}
