DalinYYYY/JM-App/User/AppServices/StateMachine/system_state.h

/**
 * @file        system_state.h
 * @brief 		系统状态机核心头文件
 * 
 * @author      yangsl (yangsl@robot.com)
 * @version     1.0
 * @date        2026-06-11
 * 
 * @copyright   Copyright (c) 2026 RuidiculousTech.co, Ltd. All rights reserved.
 * 
 * 
 * @par 修改日志:
 * | 日期       | 版本 | 作者   | 修改内容   |
 * |------------|------|--------|------------|
 * | 2026-06-11     | 1.0  | yangsl | 初始创建   |
 * 
 * @note        本文件遵循《嵌入式C代码规范V1.0》开发
 * 
 * @details 定义系统状态机的核心数据结构、状态切换接口、控制循环入口等，
 *          负责电机控制系统的顶层状态管理（包括故障处理、运行模式切换、控制指令处理）
 */

#ifndef __SYSTEM_STATE_H__
#define __SYSTEM_STATE_H__

#include <stdbool.h>
#include "state_define.h"
#include "motor_control.h"
#include "ctrl_transition_mgr.h"
#include "calib_types.h"

/* 前向声明，避免 system_state.h 直接依赖 dev_motor.h */
struct dev_motor;

#define SYSTEM_PROTECT_OVER_CURRENT  (1u << 0)
#define SYSTEM_PROTECT_OVER_VOLTAGE  (1u << 1)
#define SYSTEM_PROTECT_UNDER_VOLTAGE (1u << 2)
#define SYSTEM_PROTECT_OVER_TEMP     (1u << 3)
#define SYSTEM_PROTECT_OVER_SPEED    (1u << 4)
#define SYSTEM_PROTECT_GATE_DRIVER   (1u << 5) /* 栅极驱动器硬件故障保护(nFAULT) */

#define SYSTEM_FAULT_OVER_CURRENT  (1u << 0)
#define SYSTEM_FAULT_OVER_VOLTAGE  (1u << 1)
#define SYSTEM_FAULT_UNDER_VOLTAGE (1u << 2)
#define SYSTEM_FAULT_OVER_SPEED    (1u << 10)
#define SYSTEM_FAULT_NUMERIC       (1u << 11)
#define SYSTEM_FAULT_GATE_DRIVER   (1u << 12) /* 栅极驱动器故障(nFAULT 拉低, OCP/UVLO/TSD) */

typedef struct system_state_s
{
	top_fsm_e top_state;        /*!< 顶层有限状态机状态 */
	ctrl_mode_e ctrl_mode;      /*!< 当前控制模式 */
	uint32_t fault_code;        /*!< 系统故障码(fault_mgr 兼容掩码派生) */
	motor_ctrl_t motor;         /*!< 电机控制核心上下文 */
	transition_mgr_t trans_mgr; /*!< 过渡管理器（内含 transition_t + ref_smooth_cfg） */
	calib_state_e calib_state;  /*!< 标定子状态（仅 CALIB 态有效）*/
	uint32_t fault_latched;     /*!< 已锁存故障掩码（清除前持续生效, fault_mgr 派生） */
	uint16_t fault_count;       /*!< 故障累积计数 */
	uint8_t last_fault_code;    /*!< 最近一次故障编号 */
} system_state_t;

/**
 * @brief 运行模式平滑过渡的调用次数（可配置，rate 不适用时的兜底时长）
 * @details 过渡时长以 motor_control_loop（建议在电流环中调用）的调用次数计，
 *          而非软件定时器。配置值 = 期望过渡时长 / 电流环周期。
 *          smooth_cfg 任一 rate>0 时模式切换过渡按速率重算时长，覆盖此值。
 */
extern uint32_t g_run_state_trans_count;

/**
 * @brief 初始化系统状态机
 * @param[in,out] sys 系统状态机实例指针（非NULL）
 * @param[in] motor 底层电机设备指针（供标定模块操作 FOC/编码器/半桥）
 * @param[in] param 电机参数配置指针（非NULL，含电机额定参数、PID参数等）
 * @param[in] dt 控制周期（单位：秒，如1e-4表示100us）
 * @retval 无
 * @note 会初始化电机控制上下文、状态过渡器，并将顶层状态初始化为IDLE
 */
void system_state_init(system_state_t *sys, struct dev_motor *motor, motor_param_t *param, float dt);

/**
 * @brief 切换顶层有限状态机状态
 * @param[in,out] sys 系统状态机实例指针（非NULL）
 * @param[in] new_state 目标顶层状态（如TOP_FSM_IDLE/TOP_FSM_RUN/TOP_FSM_FAULT等）
 * @retval 无
 * @note 1. 若目标状态超出范围或与当前状态一致，不执行任何操作；
 *       2. 切换前会处理原状态的收尾（如RUN切其他状态时清零电压、复位PID）；
 *       3. 切换后会初始化新状态的核心参数（如FAULT状态清零电压）
 */
void top_fsm_switch(system_state_t *sys, top_fsm_e new_state);

/**
 * @brief 切换电机运行状态（带平滑过渡）
 * @param[in,out] sys 系统状态机实例指针（非NULL）
 * @param[in] new_state 目标运行状态（如RUN_STATE_POSITION/RUN_STATE_TORQUE等）
 * @param[in] trans_count 过渡时长（以 motor_control_loop 的调用次数计，非毫秒）
 * @retval 无
 * @note 1. 若目标状态超出范围或与当前状态一致，不执行任何操作；
 *       2. 会启动参考层过渡器；同量纲模式做参考线性混合，异量纲模式
 *          直接切换并依赖下游三环预装载积分实现无扰切换
 */
void run_state_switch(system_state_t *sys, run_state_e new_state, uint32_t trans_count);

/**
 * @brief 电机控制主循环（中断级执行）
 * @param[in,out] sys 系统状态机实例指针（非NULL）
 * @param[in] fault_tick 故障检测错峰拍标志（motor_loop 超周期调度器给出）
 * @retval 无
 * @note 1. 先执行故障检测（NaN 发散每拍；电气类全量检测仅在 fault_tick 拍，
 *          1kHz 错峰，消抖阈值已按采样周期换算），故障/安全状态下参考置为IDLE；
 *       2. 处理运行状态的平滑过渡（若有），生成 motor.ref 参考输出；
 *       3. 下游三环模块读取 sys->motor.ref，按 ref.ctrl_type 入环并自行分频；
 *       4. 需在硬件中断（如定时器）中调用，保证执行周期稳定
 */
void motor_control_loop(system_state_t *sys, bool fault_tick);

/**
 * @brief 系统故障检测
 * @param[in,out] sys 系统状态机实例指针（非NULL）
 * @param[in] fault_tick 全量电气检测错峰拍标志（false 时仅执行 NaN 发散检测）
 * @retval 无
 * @note 1. NaN 算法发散检测每拍执行（保护本拍输出）；
 *       2. 电气类全量检测（过流/电压/超速/nFAULT 等）仅在 fault_tick 拍执行，
 *          消抖计数按采样周期（控制周期×FAULT_DET_FAST_DIV）等效换算；
 *       3. 检测到故障时自动切换顶层状态为FAULT
 */
void fault_check(system_state_t *sys, bool fault_tick);

/**
 * @brief 处理上层控制指令
 * @param[in,out] sys 系统状态机实例指针（非NULL）
 * @param[in] cmd 控制指令（如CONTROL_MODE_POSITION/CONTROL_MODE_CLEAR_FAULT等）
 * @retval 无
 * @note 1. 故障状态下仅响应CLEAR_FAULT指令；
 *       2. 处理IDLE/ESTOP/BOOTLOADER等顶层指令，以及各类运行模式指令；
 *       3. 运行模式指令会映射为对应运行状态，并触发平滑切换
 */
void process_ctrl_cmd(system_state_t *sys, ctrl_mode_e cmd);

#endif /* __SYSTEM_STATE_H__ */
