DalinYYYY/JM-App/(commit log)

2026-06-12 initial project structure
    [JointMotorApp_analysis.xlsx, JointMotorApp_sort_by_flash.csv, JointMotorApp_sort_by_ram.csv, motor_param.csv]
2026-06-15 添加虚拟电机模型
2026-06-15 优化模块名
2026-06-15 重构motion_param模块 - 优化速度解算 - 优化代码执行时间
2026-06-16 增加虚拟电机控制，单片机运行OK
2026-06-16 实现软件测频功能
2026-06-16 虚拟电机独立中断控: TIM5
2026-06-17 增加V1版本驱动层和设备层代码
2026-06-17 feat: 启用真实电机驱动默认配置，切换ADC触发至TIM1_CC4实现硬件闭环
2026-06-17 docs: 新增项目README与模块结构说明，明确FOC控制架构及状态机设计
2026-06-18 feat: 新增VESC串口协议栈实现设备握手与实时值上报
2026-06-18 feat: 集成VESC协议栈，配置USART1 DMA空闲中断实现异步通信【不使用VESC协议】
    [JointMotorApp_analysis.xlsx, JointMotorApp_sort_by_flash.csv, JointMotorApp_sort_by_ram.csv]
2026-06-18 feat: 新增CRC16校验与封解包状态机，完善通信协议层
2026-06-18 docs: 新增关节电机通信协议规范，明确命令码与参数索引表
    [joint_motor_command_list.csv, joint_motor_param_index.csv]
2026-06-18 feat: 增加jonit_proto协议
    [JointMotorApp_analysis.xlsx]
2026-06-18 feat: 【私有协议】新增关节电机串口通信驱动
    [JointMotorApp_analysis.xlsx]
2026-06-19 chore: 配置VS Code启用clang-format自动格式化C/C++代码
2026-06-21 feat: Add joint motor UART frame parser and Serial Studio configfeat:
2026-06-22 feat: 启用UART通信驱动并实现joint_proto协议回调
    [JointMotorApp_analysis.xlsx, JointMotorApp_sort_by_flash.csv, JointMotorApp_sort_by_ram.csv]
2026-06-22 docs: 新增电机参数C结构体定义与CSV映射表，完善EEPROM存储规划
    [motor_info.csv]
2026-06-22 feat: 拆分电机遥测数据结构并实现控制层数据同步
    [JointMotorApp_analysis.xlsx, JointMotorApp_sort_by_flash.csv, JointMotorApp_sort_by_ram.csv]
2026-06-22 fix: 修复MT6835寄存器读写越界引发栈溢出并同步SPI与GPIO硬件配置
    [JointMotorApp_analysis.xlsx]
2026-06-22 refactor: 抽离串口通信模块并拆分数据发布函数，解耦遥测同步节拍
2026-06-23 feat: GUI重构日志面板支持HTML着色与分类显示，新增流量统计并接入状态栏
2026-06-23 refactor: 封装左侧控件为滚动区并引入分割器防止界面挤压
2026-06-23 dev: gui独立成子仓库
2026-06-23 style(project): 统一 Keil 工程配置换行符
    - 规范 JointMotorApp.uvoptx 文件行尾格式
    - 保持工程配置内容不变，减少无关差异
2026-06-24 feat: 增加串口私有协议回调功能
2026-06-24 style(protocol): 统一协议文件头注释格式
    - 规范 jm_cmd_def、jm_proto、jm_proto_ops 等文件头注释
    - 统一日期、版权、修改日志等说明样式
    - 不改变协议命令定义与运行逻辑，仅整理文档外观
2026-06-24 feat(param-service): 新增上位机通信接入层
    - 引入 jm_host_commun 作为 joint_proto 的串口接入层
    - 统一复用 jm_proto_ops 业务回调，避免串口与 CAN 分叉
    - 用遥测帧打包上报替代旧的 serialstudio_commun 实现
    - 为自研 PyQt 上位机提供参数、控制和设备信息通道
2026-06-24 fix: 修复串口接受多帧失败
    [motor_info.csv]
2026-06-24 fix: 提高通信实时性
2026-06-24 fet: 添加文件
    [motor_info.csv]
2026-06-25 dev: 更新命令文件
    [joint_motor_command_list.csv]
2026-06-26 refactor: 重构运行模式节点动态生成逻辑，修复轮询控件联动异常
2026-06-26 移动工程
    [JointMotorApp_analysis.xlsx, JointMotorApp_sort_by_flash.csv, JointMotorApp_sort_by_ram.csv]
2026-06-26 dev: CubeMX工程目录重构
2026-06-26 feat(config): 增加板级配置切换
    - 新增 `board_select.h` 统一选择 V1 与 SFOC 板卡
    - 拆分设备配置接口与板级资源表，降低耦合
    - 补充 V1 板级设备使能和对应配置实现
    - 更新 `.gitmodules` 以纳入 SFOC 子模块
2026-06-26 dev: 优化多工程配置
2026-06-29 docs: 重写 README 并同步 SFOC/pyqt_gui 子模块指针
2026-06-29 fix(mt6701): 修复 CRC6 校验并增加 SSI 帧偏移自对齐
    - 使用 MagnTek 官方 6-bit 分组查表法替换逐 bit CRC6
    - 多读 1 字节并在 0~8 bit 偏移内用 CRC 自校验定位帧边界
    - 增加 err_cnt/bit_offset 字段，坏帧时保持上一帧角度
    - 添加 MT6701 驱动说明文档
    - 在 board_select.h 增加 JM_BOARD_SFOC 选项
    - 同步协议反馈字段注释为电机端/输出端语义
    - 更新 pyqt_gui 子模块指针
    [board_select.h, dev_mt6701.c, dev_mt6701.h, jm_proto.h, jm_proto_ops.c]
2026-06-29 fix(motor-loop): 设置速度解算频率为实际节拍并改用 PLL 观测器
    @速度解算频率需等于速度环真实节拍(电流环/VEL_DIV)，否则 d(angle)/dt 标定错比例；PLL 观测器相比后向差分对编码器量化噪声更平滑、低滞后。@
    [dev_motor.c, motor_loop.c]
2026-06-29 build: 取消 sct 忽略规则并添加 STM32G474 链接散列文件
    之前 *.sct 被 .gitignore 排除，导致 Keil 链接脚本未纳入版本管理。取消忽略并添加 stm32g474xx_flash.sct。版本回退时不会因缺少 sct 而编译失败。
2026-06-29 chore(skill): 添加 stm32-drv-wrapper 技能定义
2026-06-29 chore(skill): 添加 embedded-dev-object 技能并补充 stm32-drv-wrapper 规范
2026-06-29 增加末尾注释对齐的格式功能
2026-06-30 docs： add motor info
    [motor_info.csv]
2026-06-30 feat(protocol): 添加电机信息表及协议命令扩展
    - 新增 User/DataHub/motor_info.c/h(由 motor_info_generate.py 生成)
    - 新增 motor_info_generate.py 代码生成器
    - 扩展 jm_cmd_def.h/jm_proto.h 协议命令定义
    - 更新 jm_proto_ops.c 实现反馈与参数处理
    - 更新 board_select.h 板卡选择配置
    - 更新 runtime_param.h 运行参数
    - 更新 motor_info.csv 及命令列表文档
    [joint_motor_command_list.csv, motor_info.csv]
2026-06-30 feat(foc): 两相电流重构及ADC触发时序优化
    - foc_core.c: Clarke变换前丢弃占空比最大相, 用两相重构缓解高调制下低边采样窗口不足的问题
    - dev_config.h: ADC触发CCR从8380调节至8480, 更贴近波峰(偏离约118ns)
    - 新增相电流采样PWM触发ADC时序说明文档(含INA199B1建立时间分析)
    - 更新pyqt_gui子模块指针
    [dev_config.h, foc_core.c]
2026-07-01 refactor(motor): 重构控制流与模式分发，扩展状态机运行模式【开环运行OK】
    - current_loop: 接口改为 ctrl_type 分流，支持 VOLTAGE/DUTY/IDLE 直通
    - motor_loop: 编码器刷新移至 ISR 开头统一执行，外环条件执行
    - cascade_control: 无扰预装载仅对闭环模式生效
    - state_define: 新增 HOLD/PROFILE_VELOCITY/PROFILE_TORQUE 运行模式
    - system_state: 新增 CANOpen/EtherCAT/CALIB 模式路由，READY→RUN 使用平滑过渡
    - motor_control: 改用 s_mode_table 函数指针表替换分散的 run_*_control
2026-07-01 feat(calibration): 添加七层标定框架并集成状态机与协议
    - 新增 User/MotorCalibration/ 完整标定模块：
    - calib_types.h: 标定类型定义(层级/状态/参数/结果)
    - calib_mgr.c/h: 标定管理器+7层 Run/Next/Abort 状态机
    - calib_level1~7: 驱动/电机/编码器/力矩/非线性/系统/全自动各层桩
    - state_define.h: 新增 CALIB 顶层状态与 12 种校准控制模式
    - system_state.c/h: IDLE→CALIB 路由, CALIB 态停位置环直通电流
    - protocol: jm_cmd_def.h/ops 扩展校准命令, command_list 更新
    - motor_mode.h: 新增 motor_mode_calib_run 校准运行模式
    - 新增设计文档 User/Data/plans/2026-07-01-calibration-state-mac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
    [joint_motor_command_list.csv]
2026-07-01 feat(calibration): 实现 L3 编码器零位/方向标定，集成标定硬件接口
    - calib_types.h: 新增 calib_io_t 硬件访问接口(motor/param/dt)
    - calib_mgr.h/c: init 接收 dev_motor 指针, 新增 calib_mgr_get_io()
    - calib_level3_encoder.c: 实现零位标定(ud对齐→采样平均→写入offset)和方向标定(uq转动→delta判定→写入dir)完整状态机
    - dev_motor.c: MT6701 初始化从 usr.motor_param 加载已标定的 enc_offset/enc_direction
    - system_state.c/h: READY 允许→CALIB 切换; 标定失败回滚 calib_mgr_abort
    - motor_loop.c: CALIB 态提前返回, 不走 cur_loop_run
    - motor_param.c: 默认 enc_offset 设为 43.77(测试值)
    - 新增 2026-07-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
2026-07-01 feat(calib): add calib_config.h centralizing calibration tunable params
2026-07-02 feat(calibration): 实现 L2 电机电气参数标定，添加标定骨架与校验工具
    - calib_step.h: 新增统一状态机骨架 step_t(reset/next/wait/accumulate/average)
    - calib_validate.h: 新增标定结果合理性校验函数集
    - calib_level2_motor.c: 实现 R(DC法)/Ld/q阶跃法/flux反电势法的完整标定算法
    - calib_level3_encoder.c: 重构使用 step_t 骨架，增加 mark_done/validate
    - calib_level7_auto.c: 实现全自动标定序列执行(遍历L1~L6 ops表)
    - calib_mgr: 新增 mark_done/check_done/is_all_done 位标记追踪
    - calib_hw: 电压施加增加幅值安全互锁(超限缩放到 CALIB_CFG_MAX_VOLTAGE_MAG_V)
    - calib_config.h: 新增 L2 测试参数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
    [calib_config.h, calib_hw.c, calib_hw.h, calib_level2_motor.c, calib_level3_encoder.c, calib_level7_auto.c, calib_mgr.c, calib_mgr.h]
2026-07-02 fix(current-sensor): 修复 ADC 零位校准时序并添加编码器方向运行时切换
    - 修复 ADC 零位校准在 half_bridge.start 之前执行导致采样值无效的问题
    - 校准时序调整为: phase_current.start -> half_bridge.start -> HAL_Delay(2) -> calibrate_offset(均值256次)
    - PHASE_CURRENT_ZERO_ADC 默认值从 2024 修正为 2048(INA199B1 REF=1.65V)
    - 新增 dev_motor_set_encoder_dir / motor_loop_set_encoder_dir 运行时切换方向 API
    [current_loop.c, dev_config.h, dev_motor.c, dev_motor.h, dev_motor_phase_current.c, motor_loop.c, motor_loop.h]
2026-07-02 feat(config): 新增 motor_profile 电机参数配置中心，标定参数自动派生
    - 新增 User/Config/motor_profile.c/h 作为电机电气身份参数唯一真相源，
    当前内置 GM4820H 参数（来源 GM4820H参数_2024.pdf），通过 MOTOR_PROFILE
    宏切换型号
    - motor_loop_init / motor_info_init / 参数复位路径在 init 后追加
    motor_profile_apply_param/info，覆盖 R/Ld/Lq/flux/pole_pairs 等字段
    - calib_config.h 所有测试电压/时间/合理性范围从 MOTOR_* 派生
    （τ=Ld/R、测试电流=峰值×14%、容差±50%），切换电机型号自动适配
    - jm_proto_ops 标定启动失败新增 STATE_DENY NACK，区分前置依赖未完成
    - 删除已完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
2026-07-02 docs：更新User文件结构说明.md说明
2026-07-02 docs：更新README.md说明
2026-07-02 feat(storage): 实现 motor_info Flash 持久化，修复 drv_flash_g4 双Bank地址
    - 新增 User/Devices/dev_flash.c/h 通用片内 Flash 页存储设备：
    init 传(地址,总大小,页大小)，扇区首 u64=flag(magic+seq)，
    写入轮转扇区实现磨损均衡，init 扫描找 seq 最大有效扇区
    - 新增 User/AppServices/ParamService/motor_info_storage.c/h
    应用层设备对象，按 C-OOP 规范设计：static const ops 方法表 +
    extern 单例 + 组合 dev_flash 子设备；init 一次性完成
    dev_flash_init→motor_info_init→Flash加载→motor_profile_apply_info
    覆盖；强符号 jm_app_motor_info_storage_save 覆盖协议层弱符号接入 0xEA
    - 新增 User/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
    [dev_eeprom.c, dev_flash.c, dev_flash.h, drv_config.h, drv_flash_g4.c, drv_flash_g4.h, jm_proto_ops.c, motor_info_storage.c]
2026-07-03 feat(calibration): 新增标定结果回流 API，重构 enc_offset 为 float deg
    - 新增 motor_info_calib.c/h：提供 submit_r/ld/lq/flux/pole_pairs/
    enc_zero/enc_direction/mark_calibrated/reset API，按子模式粒度
    将标定结果回流到 motor_info 持久化层
    - enc_offset 字段从 int32_t(counts) 重构为 float(deg)，统一
    motor_info 与 motor_param 全链路（字段/setter/validate/dispatch/
    dev_motor 装配），同步协议文档与 CSV
    [joint_motor_param_index.csv, motor_info.csv, motor_param.csv]
2026-07-03 feat(calibration): 标定结果回流 motor_info，init 增加 config_version 校验
    - motor_profile_apply_info 改为零值 fallback 语义（已标定字段保留，
    未标定字段用 profile 覆盖），新增 apply_info_default 用于首次上电
    - motor_info_storage_init 增加 config_version 校验，版本不匹配时
    触发重新初始化；首次上电自动 init + apply_default + save 到 Flash
    - calib_level2/3/7 各子模式完成后调用 motor_info_calib_submit_*
    将标定结果实时回流到 motor_info（R/Ld/Lq/flux/pole_pairs/
    enc_zero/enc_direction/mark_calibrated）
    - calib_validate_enc_offset 改为 float deg 范围校验
2026-07-03 feat(encoder): dev_encoder_t 抽象层扩展标定接口，编码器标定不直接依赖具体芯片
    - dev_encoder_t 新增 set_offset/get_offset/set_dir/get_dir/get_raw_deg
    五个标定扩展接口，方向统一 -1/1 约定，角度统一 deg 单位
    - dev_mt6701 方向枚举从 0/1 重构为 1/-1，统一方向约定
    - dev_motor_init / set_encoder_dir 统一通过抽象层访问编码器，
    不再直接操作具体芯片字段
    - calib_hw_get_encoder_raw_deg 改为通过抽象层访问，不再依赖 dev_mt6701.h
    - calib_level3_encoder 删除对 dev_mt6701.h 的直接依赖
    - motor_profile_apply_info 增加 enc_direction 零值 fallback（默认 CW）
2026-07-03 refactor(encoder): 将编码器适配层剥离到独立文件，dev_motor.c 不再直接依赖具体芯片型号
2026-07-03 feat(calibration): 补上 Flash 标定参数到运行期 motor_param 的同步桥接
    新增 motor_profile_sync_to_param()，在 motor_loop_init 中于
    motor_profile_apply_param 之后调用，将 motor_info_storage_get() 读取的
    Flash 标定值同步到控制环实际使用的 motor_param_t：
    - 电气参数（R/Ld/Lq/flux/kt/inertia/pole_pairs）仅当 is_calibrated==1 时
    用 Flash 值覆盖 profile 默认值
    - 编码器参数（enc_direction/enc_offset/elec_angle_bias）始终同步，
    enc_offset/elec_angle_bias 保留 0 表示未标定
    同时更新 pyqt_gui 子模块指针。
2026-07-03 feat(calibration): 改用开环电角度扫描辨识极对数
    通过命令电角度累计与编码器机械角累加的比值直接计算极对数，避免依赖派生电角度反推导致的循环自证问题。
2026-07-06 feat(calibration): 真实电机标定启用母线电压归一化
    在标定时接入电源监控并按 Vbus 归一化 SVPWM 输入，避免真实电机把电压值误当占空比导致过调制和标定结果失真。
2026-07-06 feat(power): 将电源监控移至任务层并修正 IBUS 零偏与采样参数
    提高周期任务频率后在 100ms 刷新母线电压/电流与温度，并按放大器的零电流偏置修正 IBUS 计算，避免 ISR 内重复读取电源监控数据。
    [dev_config.h, dev_power_monitor.c, dev_power_monitor.h, motor_loop.c, thread_config.h, thread_management.c, thread_period.c, user_interface.c]
2026-07-06 fix(calibration): 在 CALIB 态刷新相电流采样
    确保标定流程中的 R/Ld/Lq/flux 读取到实时电流，避免被 CALIB 态直接 return 后跳过采样更新。
    [motor_loop.c]
2026-07-06 feat(calibration): 可配置 L7 一键标定子项
    通过 0/1 开关按需组合 L1-L6 标定流程，默认保留电机基础项与编码器标定，便于在不改算法的情况下裁剪一键标定内容。
2026-07-06 feat(calibration): 细化 0x97 标定状态查询为详细可观测信息
    将标定进度查询从单纯 ACK/NACK 扩展为可返回 step、fail_reason 和 L7 序列进度，方便上位机直接定位单步标定卡点与一键标定执行阶段。
    [joint_motor_command_list.csv]
2026-07-07 chore: 统一作者邮箱并整理代码格式
2026-07-07 docs(protocol): 补充 joint_proto 文件逻辑、解析流程与实时性文档
    新增协议栈跨文件调用关系图、命令解析详解和通信实时性评估，便于后续排查链路依赖、理解分发规则与评估 UART/CAN 时延。
2026-07-07 feat: 为 sys_data_t 增加调试映射指针以统一观察全局数据
    通过指针而非拷贝把 dwt_timer、s_motor_loop、g_motor_info_storage 及电源/UART 设备挂到 usr 上，便于在调试器中实时查看和定位问题。
    [dev_dwt_counter.h, motor_loop.h, runtime_param.h, user_interface.c]
2026-07-07 feat: 开环电压支持独立 d/q 轴电压并同步透传
    在电压模式下新增 ud 参考量，并将过渡流程一并插值，避免开环与切换过程中 d/q 轴电压被忽略。
2026-07-08 feat: 真实电机电流环开环电压按母线电压归一化
    在 SVPWM 归一化输入下将开环 d/q 轴电压除以 Vbus，避免电压值被误当作占空比导致过调制和幅值失真。
2026-07-08 feat(transition): 重构过渡管理并支持同模式参考渐变
    将模式切换过渡收敛到 transition_mgr，统一管理启动、更新和强制结束，并为同一运行模式内的目标突变增加参考层平滑，避免参考阶跃带来的电机抽动。
2026-07-08 feat: 将真实电机控制环频率调整为10kHz并同步修正参数
    同步更新电流/速度/位置环分频说明、PWM与采样周期、以及电流环PI参数，确保控制周期变更后参数配置与SVPWM电压归一化一致。
2026-07-08 feat: 新增 PID 管理模块并支持理论估计与独立来源切换
    将 PID 参数加载、理论整定和协议控制从原控制流程中拆分出来，支持电流/速度/位置环独立选择默认值、Flash 工程值或理论估计值。
2026-07-08 docs(pid): 更新PID管理文档与示例描述
    [joint_motor_command_list.csv]
2026-07-08 style: 统一电机控制相关代码格式并调整PID默认参数
    整理电机控制模块的缩进与对齐，顺带更新电流环和速度环的默认PID参数。
2026-07-09 feat(motor_info): 扩展参数范围并支持启动时PID三级回退
    将电机配置参数的默认值、校验范围与注释同步放宽，以匹配更大的标定与控制场景；同时在上电加载阶段引入 Flash、autotune、默认值的三级回退，避免无效配置影响三环初始化。
    [motor_info.csv]
2026-07-09 fix(pid): 修正电流环和速度环默认参数并移除示例文件
    调整 current_q、velocity、position 三个 PID 默认值以匹配当前控制配置，同时删除不再需要的串口协议接入示例文件并更新子模块引用。
    [motor_pid_profile.c]
2026-07-09 feat(pid): 支持调试模式下PID参数实时写读并迁移命令码
    新增 DEBUG source 与 0xA5/0xA6 实时参数读写能力，PID 来源命令同步迁移到 0xA0~0xA2；同时把来源持久化到控制参数中，便于上电恢复与调试态切换。
    [joint_motor_command_list.csv, motor_info.csv]
2026-07-10 fix(pid): 修正PID来源参数空指针返回码
2026-07-10 feat(motor_mode): 新增多种电机模式的中英文控制框图页
    补充电流、位置、速度、力矩、开环、空闲、保持、MIT、轮廓与扫频测试等模式的深浅色 HTML 说明页，统一用于可视化各模式信号流与参数定义。
    同时更新 PyQt GUI 子模块引用以配合新的模式页面资源。
2026-07-10 fix(svpwm): 修正SVPWM作用时间幅值标定偏差
    将SVPWM扇区作用时间按标准幅值关系重算，并补入1.5倍幅值补偿，避免输出电压统一偏小导致开环标定与电阻辨识结果失真。
    同时提高L2R稳态采样次数，增强电阻测试结果的稳定性。
    [calib_config.h, foc_core.c]
2026-07-10 fix(motor_calibration): 改为两点差分法识别电机电阻
    在低、高两档稳态电压下分别采样电流并做差分计算，抵消死区、MOSFET Rds 和体二极管带来的恒定压降偏差，避免单点 R=V/id 将命令电压直接当作实际相压而系统性抬高电阻辨识结果。
    [calib_config.h, calib_level2_motor.c]
2026-07-13 fix(motor_calibration): 降低电阻辨识稳态采样次数
    将 L2R 电阻测试的每档稳态采样次数从 2000 次下调到 500 次，以减少校准过程耗时，并保持两点差分法的辨识流程不变。
    [calib_config.h]
2026-07-13 fix(power_monitor): 支持母线电流合成源并修正零矢量下输出
    在旧版硬件 ADC 采样与新版三相电流+SVPWM 合成两种母线电流来源间切换，
    避免合成源被任务层的硬件读取覆盖，并在零电压指令时正确输出零矢量占空比，
    保证母线电流遥测与 PWM 状态一致。
    [dev_config.h, dev_power_monitor.c, dev_power_monitor.h, foc_core.c, motor_loop.c, thread_period.c]
2026-07-14 feat: MKS Board
2026-07-15 chore(board): save ODriveMKS changes before converting to submodule
2026-07-15 chore(board): untrack Board/ODriveMKS for submodule conversion
2026-07-15 chore(board): convert Board/ODriveMKS to submodule
    参考 Board/SFOC 模式, 将 Board/ODriveMKS 转为独立子仓库管理。
    .gitignore 规则与 SFOC 一致(排除 *.o/*.axf/*.hex 等编译产物)。
2026-07-16 feat(mcu_compat): 新增跨系列 MCU 兼容判定头
    引入 mcu_compat.h 作为 MCU 系列判定的单一入口, 以 Keil 预定义的
    HAL 标准宏(STM32F405xx / STM32G474xx 等)为唯一事实源, 替换散落在
    drv_*.c 中的 STM32F4 / STM32G4 / STM32H7 硬编码宏。
    主要内容:
    - mcu_compat.h: JM_MCU_F1/F3/F4/G4/L4/H7 系列 + JM_PERIPH_CAN_CLASSIC/FD
    + JM_PERIPH_ADC_CALIB_DUAL/SINGLE 外设分组
    - drv_config.h: FLASH_MCU 由手动宏改为 mcu_compat.h 自动派生
    USE_FLASH_F4_DRIVER / USE_FLASH_G4_DRIVER
    - drv_adc.c: STM32G4||STM32L4||STM32H7 -> JM_PERIPH_ADC_CALIB_DUAL_PARAM,
    STM32F1||STM32F3 -> JM_PERIPH_ADC_CALIB_SINGLE_PARAM; ADC_SINGLE_ENDED/
    ADC_DIFFERENTIAL_ENDE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
2026-07-16 feat(board): 新增 JM_BOARD_ODRIVE 板级选择与板级参数覆盖机制
    引入 ODrive Mini 板宏切换, 并通过 #ifndef 守护机制允许 board 配置文件
    覆盖通用参数。
    - board_select.h: 加 JM_BOARD_ODRIVE 选项与互斥检查; 新增 ODrive board
    include 路径
    - dev_config.h: PM_VBUS_RATIO / HALF_BRIDGE_ADC_TRIG_CCR / PHASE_CURRENT_GAIN
    / PHASE_CURRENT_SHUNT / PHASE_CURRENT_ZERO_ADC 全部加 #ifndef 守护,
    允许 ODrive 板的 dev_config_board.h 覆盖; HALF_BRIDGE_ADC_TRIG_CCR 加
    F4 TIM1 Period=8400 注释提醒
    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
2026-07-16 feat(drv_flash): 新增 F4 Flash 驱动(扇区擦写)
    为 STM32F405RG 提供扇区擦写 Flash 驱动, 跳过 G4 路径的整页读改写
    (128KB 缓冲会撑爆 RAM), 单扇区擦除 + flag+data 一次写入。
    - drv_flash_f4.c/h: F4 扇区擦除 + word 编程接口
    - dev_flash.c: dev_flash_write 加 #if USE_FLASH_F4_DRIVER 分支,
    使用静态 f4_buf[257] 容纳 flag+data, 避免栈溢出
    - dev_flash.h: 按 USE_FLASH_G4_DRIVER / USE_FLASH_F4_DRIVER 包含对应头
    - motor_info_storage.h: MOTORINFO_FLASH_START_ADDR / TOTAL_SIZE / PAGE_SIZE
    加 #ifndef 守护, 允许 ODrive 板覆盖为 Sector 11 (0x080E0000, 128KB)
    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
2026-07-16 fix(motor_info_storage): 保存前阻断范围校验失败并增加回读校验
    修复"保存时绕过范围校验、下次上电必然 verify 失败重走默认路径"的隐患,
    并在写入后立即回读走与上电完全相同的校验链, 当次就能区分擦写失败 vs
    数据校验失败。
    - motorinfo_ops_save: (void)motor_info_validate 改为阻断式,
    vrc != 0 直接返回错误码
    - motorinfo_ops_save: 写入 dev_flash 后立即回读并调用 motorinfo_verify,
    走与上电完全相同的校验链
    - motor_info_storage_init: 路径 B3 捕获 motorinfo_ops_save 返回值,
    save 失败时下次上电仍走路径 B 加载默认值
    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
    [motor_info_storage.c]
2026-07-16 feat(drv8301): 新增 DRV8301 门极驱动器与 2-shunt 相电流采样
    新增 DRV8301 SPI 驱动(CTRL1/CTRL2 配置 GAIN=40V/V、DC_CAL=0),
    并在相电流采样层支持 2-shunt 模式(合成相由基尔霍夫定律计算)。
    - dev_drv8301.c/h: DRV8301 SPI 寄存器读写, CTRL1=0x003C(GAIN=40V/V,
    DC_CAL=0), CTRL2=0x0006(GATE_CURRENT=3.0A, 6PWM mode)
    - dev_config.c: 仅包含 dev_drv8301.h(dev_as5047.h 见后续 commit)
    - dev_motor_phase_current.c: start 阶段跳过合成相 rank 分配;
    get_value 加 DRV8301_TWO_PHASE_SYNTH_PHASE 分支用基尔霍夫合成
    - user_interface.c: hardware_init 加 #if defined(USE_DEV_DRV8301) 包裹的
    dev_drv8301_init + g_dev_drv8301.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
2026-07-16 feat(as5047): 新增 AS5047 编码器驱动并接入 dev_motor
    新增 AS5047 编码器底层驱动 + dev_motor 适配层, 将其作为
    DEV_MOTOR_ENCODER_AS5047 选项接入电机对象。
    - dev_as5047.c/h: AS5047 SPI 寄存器读写, 角度读取
    - dev_encoder_as5047.c/h: dev_motor 编码器适配层
    - dev_config.c: 仅包含 dev_as5047.h(dev_drv8301.h 见前序 commit)
    - dev_motor.c: AS5047 编码器分支(#elif DEV_MOTOR_ENCODER_AS5047),
    仅含 include 与 create 调用两处, ODrive EN_GATE 引脚切换见后续 commit
    - dev_motor.h: 加 DEV_MOTOR_ENCODER_AS5047 = 3 宏定义,
    默认编码器类型改为 DEV_MOTOR_ENCODER_AS5047
    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
2026-07-16 feat(dev_motor): 支持 ODrive 板 EN_GATE 引脚(PB12)
    通过 JM_BOARD_ODRIVE 宏切换 EN_GATE 引脚:
    - ODrive Mini: EN_GATE = PB12 (DRV8301)
    - SFOC/V1: EN = PB2
    未定义 JM_BOARD_ODRIVE 时保持原 SFOC/V1 配置不变, 行为向后兼容。
2026-07-16 feat(power_monitor): 支持合成源通道并修正 DMA rank 分配
    引入 ch_rank 字段记录每个逻辑通道在其 ADC 的 DMA 序列中的 rank,
    合成源通道(无 ADC 配置)跳过校准与 DMA 启动, 避免 assert_report(0)。
    - dev_power_monitor.h: 结构体加 ch_rank[PM_CH_MAX], 有效通道=0~N-1,
    无 ADC 配置(合成源)=0xFF
    - dev_power_monitor.c: start 阶段分配 rank 并跳过合成源;
    get_vbus/get_ibus 用 ch_rank[PM_*] 索引, 加 assert 守护
    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
    [dev_power_monitor.c, dev_power_monitor.h]
2026-07-16 fix(drv_usart): 修复 F4 HAL UART ORE 错误导致接收永久瘫痪
    覆写 HAL_UART_ErrorCallback, 在 F4 HAL 因 DMA 总线负载高触发
    ORE/NE/FE 错误并永久禁用 DMAR 位时, 清标志 + 停 DMA + 重启 DMA
    接收 + 重新使能 IDLE 中断。G4 上为冗余保护不影响功能。
    根因:
    F4 HAL 的 __HAL_UART_CLEAR_IDLEFLAG 宏通过读 SR + 读 DR 清标志,
    在 DMA 总线负载高时会引发 ORE 错误, 导致 UART 接收中断永久禁用。
    G4 HAL 改为写 ICR 不读 DR, 错误概率极低。
    参考: 项目记忆 2026-07-15 标定期间 UART 接收失效问题
    [drv_usart.c]
2026-07-16 feat(motor_profile): 新增 MKS 5010 360KV 电机配置
    新增 MOTOR_PROFILE_5010_360 选项, 使用厂家参数:
    - 相电阻 R = 0.12Ω (120mΩ)
    - 相电感 Ld = Lq = 50μH (SPMSM)
    - 极对数 = 7 (12N14P)
    - 最大电流 20A, 电压 DC12~24V
    派生计算:
    - 磁链 flux = 60/(2π·KV·pp) = 60/(2π·360·7) ≈ 3.79e-5 Wb
    - 转矩常数 KT = 1.5·pp·flux ≈ 0.398e-3 Nm/A
    注: KV 法反算磁链对低 KV 大电机偏小, 实际应以堵转转矩实测为准
    同步递增 MOTOR_PROFILE_CONFIG_VERSION 1 -> 2 触发 Flash 参数重新初始化;
    MOTOR_PROFILE_DEMO 编号顺延为 3。
2026-07-16 fix(calib): 适配低电阻电机 R 标定(宽范围+电流限流+允许负电流)
    解决 MKS 5010 (R=0.12Ω) R 标定持续失败问题:
    1. R 校验范围: MOTOR_R × [0.1, 10] 改为固定宽范围 [0.01, 50] Ω
    原因: 低电阻电机死区非线性使两点法结果可能偏离标称值数倍,
    过窄范围会误拦。宽范围仅拦截明显异常(短路<0.01 / 断路>50)。
    2. 测试电流基准: 峰值 × 0.14 改为 min(峰值 × 0.3, 1.5A)
    原因: 5010 电机 R=0.12Ω, 按原公式 I=6A 时 V=0.72V, 但电源限流
    2A 会导致电压塌陷, 测试失败。1.5A 上限对应 V=0.18V, 安全。
    3. 电流方向检查: id < 0.001f 改为 fabsf(id) < 0.001f (两处)
    原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
    [calib_config.h, calib_level2_motor.c]
2026-07-16 fix(motor_info): 放宽 torque_constant 下限支持低 KT 电机
    MKS 5010 KV=360 反算 KT ≈ 0.398e-3 Nm/A, 原下限 0.001 会误拦,
    改为 0.00001。同步 Tools 下自动生成源, 保持 CSV -> 生成器 ->
    数据文件链一致。
    变更:
    - motor_info_validate: torque_constant 下限 0.001 -> 0.00001
    - motor_info_set_torque_constant: 同上
    - motor_info.csv: torque_constant min 列 0.001 -> 0.00001
    - motor_info.c/h (DataHub 与 Tools 副本): 自动生成日期更新为 2026-07-15
    [motor_info.csv]
2026-07-16 style(control_irq): 修正电流环中断频率注释为 10KHZ
    仅注释修改, 无逻辑变化。ADC 注入中断实际频率为 10KHZ,
    原注释 20KHZ 与 motor_loop_init(10000.0f) 不一致。
    [control_irq.c]
2026-07-16 docs: 归档方案文档与 MotorControl 说明
    把本次开发期间产生的方案文档与说明文档一次性归档,
    避免散落 untracked。
    - User/Data/docs/git-commit/SKILL.md: git-commit 规范化提交 Skill
    - User/Data/plans/2026-07-13-odrive-mini-migration.md: ODrive Mini 板移植方案
    - User/Data/plans/2026-07-15-user-code-sfoc-compatibility.md:
    User 代码 SFOC 兼容性分析与优化方案
    - User/MotorControl/docs/MotorControl_说明文档.md: 电机控制模块说明
2026-07-16 chore: 归档主仓按功能拆分提交方案
    整理主仓当前变更的分提交计划，按依赖顺序拆分为独立语义化提交，方便后续在 develop_mks 分支上逐步提交并控制变更范围。
2026-07-16 refactor(config): 将板级配置显式化并强化编译期校验
    把原先分散在通用配置中的板级参数下沉到各板的 dev_config_board.h，
    并在 dev_config.h 中统一做缺失项校验，避免不同板卡共享默认值导致的隐式配置偏差。
    同时将通用常量与板级参数边界拆开，便于新板从 V1 配置复制后按项修改，
    减少移植时漏配 PWM、采样和 Flash 参数的风险。
2026-07-16 feat(calibration): 提升默认观测带宽并放宽标定约束
    将 PLL 观测器默认带宽从 50Hz 提高到 150Hz，并同步更新说明注释，便于在 2kHz 解算下获得更快的速度跟随。
    同时提高标定阶段允许施加的电压上限，并关闭 L2 电阻/电感/磁链自动标定项，配合新增的停止延迟过渡支持更平滑地完成停机后回到 READY。
2026-07-16 feat(state-machine): 支持 STOP 延迟过渡并补充相关单测
    为 RUN 状态增加停机延迟过渡：在支持的运行模式下先将参考值收敛到零，过渡完成后再自动回到 READY，并在停机期间拒绝其他控制命令，避免协议层继续写入新目标。
    同时新增同模式参考值渐变的单元测试，覆盖停止语义、渐变过程和完成态行为。
2026-07-16 feat(pid): 支持按环选择执行 PID 自整定并保留未选环参数
    为协议层增加 ring_select 入口，使电流/速度/位置环可按需单独或组合自整定，而不再强制一次计算三环。
    同时放宽辨识就绪判断，改为只校验关键参数有效性，兼容启动时由默认值填充的部分标定场景。
2026-07-16 feat(pid): 支持按位掩码选择 PID 自整定环路
    将自整定入口从单一环选择扩展为位掩码方式，允许电流、速度、位置环按需组合计算与写入。
    同时同步更新协议层与接口注释，并将环路生效逻辑改为按掩码分别设置来源，避免只能通过固定枚举组合调用。
2026-07-17 test: 删除参考值渐变相关单元测试和产物
    移除同模式目标值渐变的 Host 单元测试及其生成的可执行文件，并同步整理用户文档文件名。
2026-07-17 chore(repo): 忽略 .trae 工作目录
2026-07-17 feat(motor_param): 新增 DQ 解耦参数字段并重新生成 DataHub
    [motor_info.csv, motor_param.csv]
2026-07-17 feat(decoupling): 新增 FOC 电流环 DQ 解耦算法模块
2026-07-17 feat(current_loop): 集成 DQ 解耦补偿到电流环
2026-07-17 feat(protocol): 暴露 DQ 解耦参数到 0xE0-0xE5 命令表
2026-07-17 chore(cleanup): 删除过期的自动生成文件副本
    [joint_motor_param_index.csv]
2026-07-17 docs(user): 重命名用户手册文件并更新子模块引用
2026-07-20 chore(repo): 忽略 V1 板级编译产物与构建日志
2026-07-20 feat(foc_core): 支持标定模式旁路 park LPF 滤波
2026-07-20 feat(calib): 新增低阻电机适配与交流注入法基础
2026-07-20 feat(calib): 实现 L1.1 ADC 偏置标定
2026-07-20 feat(calib): 实现 L5.3 死区补偿三点拟合标定
2026-07-20 feat(board): V1 板级未启用 USE_DEV_FLASH 适配
2026-07-20 chore(config): 切换默认电机配置为 5010_360
2026-07-20 chore(project): 更新 Keil 工程加入新增源文件
2026-07-20 feat(motor_info): 新增 peak_current/max_speed 字段并重新生成
    [motor_info.csv]
2026-07-20 feat(motor_profile): 同步 peak_current/max_speed 并升级配置版本号
2026-07-20 refactor(calib): 标定参数从编译期宏改为运行期派生
2026-07-20 refactor(calib): L2/L3/L5/AC 注入模块迁移到运行期派生参数
2026-07-20 feat(motor_info_calib): 新增 reset_for_recalibration 与三大场景操作手册
    [motor_info_calib.c, motor_info_calib.h]
2026-07-20 feat(protocol): 新增 0xEC 重新标定复位命令
2026-07-20 fix(motor_info_storage): 修复 CRC 计算栈溢出导致 MemManage 异常
    [motor_info_storage.c]
2026-07-20 chore(project): Keil 工程加入 calib_config_runtime.c
2026-07-21 feat(board/V1): 对齐原理图硬件配置(主编码器MT6835/相电流1mΩ/IBUS合成/NTC占位)
2026-07-21 refactor(dev_power_monitor): type字段驱动通用化改造(配置表type/scale/offset+集中换算)
2026-07-21 refactor(motor_loop): 适配电源监控配置表驱动(宏判断改has_channel运行期检测)
2026-07-21 chore(project): 更新Keil工程配置+新增原理图与RS03说明书文档+子模块指针
2026-07-21 feat(board/V1): 增加双色LED状态指示与工程配置接入
    新增 LED 设备层、状态映射管理器和线程周期更新，使 V1 板可按顶层状态输出故障/运行指示灯行为。
    同时同步更新板级配置与 Keil 工程，接入 MT6835/MT6701、LED 及相关源文件。
    [JointMotorApp_analysis.xlsx, JointMotorApp_sort_by_flash.csv, JointMotorApp_sort_by_ram.csv]
2026-07-21 feat(board/V1): 启用Flash参数存储并切换到G474双Bank布局
    新增 V1 板的 motor_info Flash 存储区定义，启用参数写入能力，并将工程与链接脚本调整为 STM32G474CETx 512KB 双 Bank 布局，预留 Bank2 末尾 4KB 作为统一参数区。
    同时将相关 Keil 工程配置、目标器件与源码文件同步接入，便于与其他板型保持一致的存储区规划。
2026-07-22 feat(mt6835): 按新手册修正方向约定并接入三字节读写协议
    根据《MT6835 Rev.1.3》整理编码器驱动，统一采用 1=CW、-1=CCW 的方向约定，并将寄存器读写、零点配置和 EEPROM 烧录切换为严格 3 字节帧格式。
    同时补充新的编码器资料文档，更新板级初始化与工程引用，确保 MT6835 适配与最新协议保持一致。
    [JointMotorApp_analysis.xlsx, JointMotorApp_sort_by_flash.csv, JointMotorApp_sort_by_ram.csv]
2026-07-22 feat(dev_mt6835): 按新手册重写SPI协议(3字节帧/21bit角度拼接/写后读回验证/方向-1,1约定)
2026-07-22 fix(board/V1): ADC1 DMA连续转换修复vbus不更新+SPI1切8bit适配MT6835三字节帧
2026-07-22 fix(motor_profile): RS03参数同步修复(去is_calibrated门控+极对数从Flash加载替代硬编码7)
2026-07-22 feat(calib): 低阻电机RS03标定适配(对齐电流6A/电压保底3V/方向预对齐/极对数上限24)
2026-07-22 fix(board/V1): 修正VBUS分压比(24.7→15.7)与电源监控刷新周期说明(100ms→20ms)
2026-07-22 chore(project): Keil工程CMSIS分组位置调整+dev_power_monitor switch缩进格式化
2026-07-23 fix(board/V1): ADC采样时序与相电流极性修正(PWM_HL接反谷底采样CCR200+INA240极性取反+ContinuousConvMode改DISABLE避免干扰注入组)
2026-07-23 feat(dev_power_monitor): 新增规则组重触发机制restart(配合ContinuousConvMode=DISABLE每周期软触发vbus/NTC刷新)
2026-07-23 feat(motor_loop): READY态执行FOC变换(Clarke/Park)便于电流采样验证(此前READY走IDLE直通无电流数据)
2026-07-23 chore(diag): 电流采样诊断工具(GPIO翻转标记注入转换时刻+Clarke两相重构临时注释+jm_dbg电角度换相核对通道)
2026-07-27 chore(project): 清理废弃通信/编码器与调试占位并同步协议定义
    删除已废弃的 SerialStudio、VOFA 和 MT6835 占位实现，去掉电流环调试 GPIO 翻转并更新 jm_dbg/0xA0/0xC9/参数表等协议约定，使工程结构、版本号与上位机接口保持一致。
    [joint_motor_command_list.csv]
2026-07-28 feat(board+drv_can): CAN FD硬件配置与驱动增强(FD模式/位定时/电机ID/通信超时降级+FIFO循环读+错误回调+TxFull+诊断字段)
2026-07-28 feat(dev_commun_can): 新增CAN通信设备层(收发/轮询/回调/心跳)
2026-07-28 feat(protocol): CAN协议支持与双协议分发(命令码重组+消息ID路由+CAN帧打包+遥测编码+广播/轮询)
2026-07-28 feat(commun): CAN传输层集成(双协议栈初始化+CAN/UART切换+debug通道)+通信超时安全降级
2026-07-28 feat(motor_info_storage): 命令触发Flash保存(0xEA方式替代定时保存,增加CRC写入校验)
2026-07-28 docs(protocol): 更新协议文档与命令表(CAN协议帧格式+消息ID路由+命令码分组+遥测编码)
    [joint_motor_command_list.csv]
2026-07-28 chore(project): Keil工程加入CAN通信源文件(dev_commun_can+drv_can加入分组)
2026-07-29 fix(drv_can): TxFIFO满时轮询等待(1ms超时)替代直接失败
    CAN/FDCAN 两路 TxFIFO 满时从立即返回失败改为轮询等待最多 1ms
    (10us 步进)，避免多帧连续发送时因 FIFO 瞬时满导致丢帧。
    [drv_can.c]
2026-07-29 feat(protocol): CAN FD运行期模式切换(0xF3命令+多帧CRC16+超时清理+冲突检测)
    - 新增 JM_CMD_SET_FD_MODE(0xF3) 命令码与 set_fd_mode 回调
    - jm_proto_can: 帧结构扩展至 64B+is_fd 字段, 运行期 FD/经典切换
    - 多帧分包末帧追加 CRC16(CCITT/XMODEM) 校验
    - 多帧重组增加 200ms 超时清理与首帧冲突检测
    - 上电默认经典模式, 兼容所有上位机硬件
2026-07-29 feat(dev_commun_can): 运行期FD模式设备层同步(use_fd_runtime+帧长度校验)
    - 新增 use_fd_runtime 字段, 上电默认经典模式, 由 0xF3 命令切换
    - jm_can_tx/on_rx_msg 根据运行期模式动态切换帧长度上限(FD=64B/经典=8B)
    - on_rx_msg 传递 now_tick 给 jm_proto_can_feed 用于多帧超时清理
2026-07-29 docs(protocol): 更新命令表(新增0xF3行)+新增CAN DBC文件
    - 命令表新增 SET_FD_MODE(0xF3) 行, NACK 行号顺延至 113
    - 新增 joint_motor_can.dbc: 119条消息/128信号/8值表, 扩展帧+float标记
    [joint_motor_command_list.csv]
2026-07-29 chore(tools): 新增DBC生成与验证脚本
    - gen_can_dbc.py: 从CSV命令表生成CAN DBC文件
    - verify_dbc.py: DBC完整性验证(cantools加载/消息数/扩展帧/float信号)
    - test_dbc.py/test_dbc2.py: DBC编解码 round-trip 测试
2026-07-29 chore(jm_host_commun): 临时关闭CAN通信超时降级(调试期)
    CAN 通信中断 500ms 超时强制切 IDLE 逻辑临时注释,
    调试期避免与上位机联调时误触发停机。
2026-07-29 chore(submodule): 更新子模块指针(ODriveMKS+SFOC+pyqt_gui)
    - Board/ODriveMKS: 清理废弃模块+新增标定/解耦/LED源文件+堆栈增至4KB
    - Board/SFOC: 芯片升级G474CE(512KB)+清理废弃模块+新增标定/解耦源文件+堆栈增至4KB
    - User/Tools/pyqt_gui: 更新至最新 commit
2026-07-29 docs(protocol): 补充关节电机 CAN 通信功能说明
    新增 CAN 协议分层、帧格式、FD 切换、多帧重组、CRC、过滤与上位机集成说明，便于统一理解协议实现与使用方式。
2026-07-30 fix(tools): 校验浮点参数时排除 NaN 和无穷值
    为生成的参数校验逻辑补充 `isfinite` 检查，避免浮点配置中出现 NaN/Inf 时绕过范围判断并写入非法值。
    [motor_param_generate_v9.py]
2026-07-30 fix(protocol): 多帧ID标志位+FD帧长度校验+载荷分片优化
    - 新增 JM_CAN_MULTI_FLAG(bit16) 多帧标志位, 替代硬编码 CMD 白名单
    - jm_can_fd_len_is_valid: FD 帧 DLC 合法性校验(仅 8/12/16/20/24/32/48/64)
    - jm_can_next_chunk: FD 模式按有效 DLC 递减分片, 经典模式固定 7B
    - can_copy_stream: 载荷+CRC 流式拷贝, 末帧 CRC 与载荷末尾连续
    - rx_buf 扩容 +2 字节容纳 CRC16
    [jm_cmd_def.h, jm_proto_can.c, jm_proto_can.h]
2026-07-30 fix(protocol): 参数写入原子性保护(快照→校验→提交)+NaN校验+模式白名单
    - app_set_mode: 用 shadow 拷贝实现原子写入, 增加 NaN 校验与模式白名单
    - app_param_write/write_bulk: 快照→motor_param_validate→提交三阶段原子写入
    - app_param_write_bulk: 增加 NULL 校验与长度完整性校验
    - app_float_is_finite: 位运算 NaN/Inf 检测(兼容 -ffast-math)
    [jm_proto_ops.c]
2026-07-30 fix(dev_commun_can): ISR接收队列解耦(ISR入队+poll出队)+硬件ID过滤
    - on_rx_msg: ISR 仅做校验+入队, 不再直接调用协议层(避免 ISR 耗时过长)
    - 新增硬件 ID 过滤: 非本机且非广播帧直接丢弃, 节省队列空间
    - poll: 从队列批量出队→喂协议层, 协议处理在通信线程上下文执行
    - 环形队列 40 槽, 溢出保护 + 统计
    [dev_commun_can.c, dev_commun_can.h]
2026-07-30 feat(safety): 实时故障检测(过流/过压/欠压/超速/NaN)+故障锁存与清除
    - state_active_faults: 每周期检测过流/过压/欠压/超速/数值异常(NaN)
    - 母线电压有效采样确认后使能过压/欠压检测(避免上电误触发)
    - fault_check 激活(原为空函数), 故障触发直接切 TOP_FSM_FAULT
    - 故障锁存机制: CLEAR_FAULT 需故障条件消失后才允许切 IDLE
    - 新增 fault_latched/count/last_fault_code/power_sample_valid 字段
2026-07-30 fix(current_loop): PWM输出NaN安全守卫+占空比饱和钳位
    - cur_pwm_compare: 安全占空比→CCR转换, NaN/负值→0, ≥1→PWM_PERIOD
    - REF_CTRL_DUTY: NaN守卫→PWM置零, 占空比[-1,1]钳位
    - IDLE/dq电压/SVPWM输出: 全部增加 NaN 守卫→PWM置零
    [current_loop.c]
2026-07-30 fix(motor_loop): 故障状态同步至motor_state+反馈电压刷新
    - motor_loop_update_feedback: 刷新 fb.bus_voltage 供故障检测使用
    - motor_loop_sync_state: 同步 fault_mask/latched/count/last_fault_code 到 motor_state
    [motor_loop.c]
2026-07-30 fix(motor_param): 所有setter增加isfinite校验防NaN注入
    50+ 个 motor_param_set_* 函数在范围检查前统一增加 isfinite() 校验,
    防止 NaN/Inf 通过上位机参数写入注入控制参数。
    [motor_param.c]
2026-07-30 fix(jm_host_commun): 恢复CAN通信超时降级逻辑
    恢复 500ms 通信中断→强制 IDLE 停机的安全机制(调试期临时关闭已结束)。
    [jm_host_commun.c]
2026-07-30 chore(submodule): 更新pyqt_gui子模块指针(多帧MULTI_FLAG+FD帧DLC校验)
2026-07-31 fix(drv_can): 双掩码过滤器驱动(经典双Bank+FDCAN全局拒绝+IDE/RTR匹配)
    - classic_filter_fill: 经典CAN 32位掩码过滤器填充, IDE/RTR位参与比较
    - 经典CAN使用两个独立Filter Bank: 单播+广播各自精确匹配低8位
    - FDCAN增加ConfigGlobalFilter全局拒绝未命中帧/标准帧/远程帧
    - drvCanDualFilter_t新增mask字段, 低8位匹配motor_id, 其余忽略
    - drv_can.h末尾补换行符
    [drv_can.c, drv_can.h]
2026-07-31 feat(can_id): motor_info持久化CAN节点ID(1~127)+硬件过滤+0xF0原子写入Flash
    - dev_commun_can_init: 启动时从motor_info Flash加载can_id(1~127), 覆盖板级默认值
    - dev_commun_can_start: 改drv_can_init(NULL)为drv_can_init_dual_filter(mask=0xFF)硬件过滤
    - motor_profile_sync_to_param: 从motor_info同步can_id到运行期motor_param镜像
    - app_set_can_id(0xF0): 写motor_info.can_id + jm_app_motor_info_storage_save()原子固化Flash, 保存失败时回滚旧地址; CAN协议/过滤器保持旧地址, ACK仍用旧ID发出, 重启后新地址生效
    - 速率限制: 0xF0从100ms改为1s防Flash反复写入损耗
2026-07-31 feat(protocol): CAN广播白名单(SYNC+ESTOP)+0xF0 ACK扩展{new_id,restart}
    - jm_proto_can_broadcast_allowed: 广播白名单, 仅开放 BROADCAST_SYNC(0xF2) 和 ESTOP(0x03)
    - on_rx_msg/jm_proto_can_feed 双重过滤: 广播非白名单命令直接丢弃, 节省CPU与队列
    - 广播命令均为单帧, 多帧广播直接拒绝, 避免跨节点重组状态冲突
    - can_dispatch_and_reply 新增reply_enabled参数: 广播时reply_enabled=0不应答
    - 0xF0 SET_CAN_ID: reply_set改为2字节{new_id, restart_required=1}, 明确提示重启后生效
2026-07-31 feat(runtime_data): user_data_init阶段写入STM32 UID+先于硬件初始化执行
    - user_data_init: 写入STM32 96bit UID(HAL_GetUIDw0/w1/w2→小端12字节device_uid)
    - user_init: 调整user_data_init到hardware_init之前, 确保后续服务/协议层使用usr时UID已就绪
    - runtime_param.h注释: 指针绑定阶段说明更新为user_init硬件初始化
2026-07-31 fix(can_id_range): motor_info/motor_param校验与默认值统一为1~127(非0~2047/0~31)
    - motor_info.can_id: 校验 1~127 (原 0~2047), 0保留为广播地址
    - motor_info_set_can_id/get_can_id: 范围同步为 1~127
    - motor_param.motor_id: 默认值从0改为1, 校验范围 1~127 (原 0~31)
    - motor_param_set_motor_id: 校验同步为 1~127
    - 与CAN仲裁ID低8位作为节点地址的硬件过滤策略一致
    [motor_info.c, motor_info.h, motor_param.c]
2026-07-31 docs(protocol+param+readme): 命令表/CSV/说明文档同步更新
    - CAN_功能说明.md: 地址过滤从宽掩码改为双掩码硬件过滤; 广播仅开放SYNC+ESTOP; 0xF0原子写入Flash ACK{new_id,restart}
    - joint_motor_command_list.csv: 0xF0行ACK扩展为{new_id;restart_required}, 注明原子写入Flash重启生效
    - joint_proto_解析流程说明.md: 0xF0流程图更新为原子保存Flash; 广播处理说明仅SYNC/ESTOP
    - motor_info.csv: can_id范围 0~2047→1~127
    - motor_param.csv: motor_id默认0→1, 范围0~31→1~127
    - MotorInfo_readme.md: can_id字段说明同步为1~127, 0保留为广播
    [joint_motor_command_list.csv, motor_info.csv, motor_param.csv]
2026-07-31 chore(submodule): 更新pyqt_gui指针(CAN节点扫描+设置ID+总线负载统计+节点发现协议)
2026-08-03 fix(system): 启动后延迟超速保护并增强编码器读数容错
    为避免编码器冷启动无效角度跳变误触发超速锁故障，并在 MT6835 SPI 读取失败时保留上一有效角度，提升上电与通信异常场景下的系统稳定性。
    [joint_motor_command_list.csv]
2026-08-03 feat(protocol): CAN-DI命令码(0xF4~0xF6)+同ID响应过滤+DI56生成+空载荷查询校验
    - 新增 JM_CMD_CAN_DI_DISCOVER(0xF4)/CAN_DI_SET_ID(0xF5)/CAN_DI_IDENTIFY(0xF6)
    - jm_proto_can_di_build: 从96-bit UID生成7字节CAN_DI56+1字节Guard(CRC16派生)
    - jm_proto_can_is_peer_response: TELEMETRY/NACK单向响应+空载荷查询的非空帧识别, 阻断同ID设备NACK反馈环
    - 广播白名单扩展: 仅开放BROADCAST_SYNC/ESTOP/CAN-DI三命令
    - jm_proto_dispatch: 0xC0~0xC9/0xD0~0xD2/0x97/0xA2 查询命令增加空载荷长度校验(LENGTH)
    - jm_proto_ops接口新增 identify_can_device 回调声明
2026-08-03 feat(drv_can): 运行期双过滤器热切换+TxFIFO空闲等待
    - drv_can_reconfigure_dual_filter: 运行期停止CAN并重新配置单播+广播双过滤器
    (经典: 停FIFO0通知+Stop; FDCAN: 停RX FIFO0通知+Stop, 仅线程/主循环调用)
    - drv_can_wait_tx_idle: 等待所有已排队报文发送完成(Tx邮箱/缓冲区空闲判定, 可超时)
2026-08-03 feat(dev_commun_can): CAN-DI发现/定向设ID/识别处理+遥测静默窗口
    - dev_commun_can_start: 启动时读取UID→生成CAN_DI56+Guard, 供CAN-DI定向识别
    - dev_commun_can_handle_commissioning: 广播F4/F5/F6专用处理(不进入通用分发)
    - DISCOVER: 校验协议版本/时隙参数, 按UID+nonce派生CRC16时隙, poll()到点后回发8B单帧
    - SET_ID: 校验DI56匹配→ops->set_can_id保存Flash→旧ID ACK后poll()热切换过滤器
    - IDENTIFY: DI56匹配→ops->identify_can_device触发物理指示→回发状态
    - dev_commun_can_apply_id: 热切换motor_id+jm实例+硬件过滤器(失败回滚旧ID)
    - on_rx_msg: 增加is_peer_response过滤, 阻断同ID节点响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
2026-08-03 feat(led): 物理识别LED快闪覆盖+0xF0状态门禁+identify回调
    - led_manager_identify: CAN-DI物理识别临时覆盖, 状态灯快闪指定时长后自动恢复
    - app_identify_can_device: 注册为ops->identify_can_device, 无USE_DEV_LED返回UNSUPPORTED
    - app_set_can_id: 增加TOP_FSM_IDLE状态门禁, 非空闲态拒绝改址(STATE_DENY)
2026-08-03 docs(protocol): CAN-DI同ID发现与改址方案文档+命令表/DBC/功能说明更新
    - 新增 CAN_DI同ID设备发现与改址方案.md: 完整载荷/压缩标识算法/异常处理/验收步骤
    - joint_motor_command_list.csv: 新增0xF4/F5/F6三行, NACK行号顺延至116
    - joint_motor_can.dbc: 新增SET_FD_MODE/CAN_DI_DISCOVER/SET_ID/IDENTIFY 4条消息
    - CAN_功能说明.md: 补充同ID响应过滤规则、CAN-DI发现流程、驱动/上位机API表
    - gen_can_dbc.py: 命令码表扩展至0xF6
    [joint_motor_command_list.csv]
2026-08-03 chore(submodule): 更新pyqt_gui指针(CAN-DI设备管理窗口+发现/改址/识别API+连接门禁)
2026-08-04 refactor(datahub): 参数访问改为表驱动dispatch+通用类型API，移除字段级get/set
2026-08-04 refactor: 调用方改用直接结构体访问与通用读写API，同步保护参数
2026-08-04 feat(config): 默认参数切换GM4820H电机(带宽/电流/磁链等)
    [motor_info.csv, motor_param.csv]
2026-08-04 feat(common): assert打印输出可配置(ASSERT_REPORT_ENABLE_PRINTF)
2026-08-04 fix(storage): motor_info flash总大小按双Bank配置初始化
2026-08-04 chore(submodule): 更新SFOC指针(G474CBTx双Bank布局+ADC1采样顺序)
2026-08-05 feat(telemetry): 新增遥测目标值组(CURRENT_TARGET/MOTION_TARGET)
    - jm_cmd_def.h: 新增 JM_TLM_CURRENT_TARGET(bit10) 和 JM_TLM_MOTION_TARGET(bit11)
    - jm_proto.h: jm_feedback_t 增加 pos_ref/vel_ref/id_ref/iq_ref 字段
    - jm_proto_ops.c: 填充遥测目标值字段, 增加 mask 校验与空mask自动全选
    - jm_host_commun.c: 打包两组新增遥测数据, 遥测缓存增至96B
2026-08-05 fix(config): 恢复默认电机型号为5010_360(非GM4820H)
2026-08-05 build(keil): 更新编译分析结果(DataHub重构后)
    motor_info.o 闪存减少约7KB(移除字段级get/set, 改为表驱动dispatch),
    jm_proto_ops.o/dev_commun_can.o 闪存增加对应协议层完善
    [JointMotorApp_analysis.xlsx, JointMotorApp_sort_by_flash.csv, JointMotorApp_sort_by_ram.csv]
2026-08-05 chore(submodule): 更新pyqt_gui指针(遥测目标值+虚拟引擎+UI适配)
2026-08-07 feat(observer): 新增motor_observer实时快照与高速采样(B7/B6/C9)
2026-08-07 feat(pid): 增强PID整定/校验与调试会话(autotune/profile/A1/A2/A5+高速采样协议接口)
2026-08-07 fix(state): 调整system_state(CALIB态切换收敛+注释fault_check+缩进整理)
2026-08-07 docs(protocol): 更新协议文档与命令清单(高速采样B7/B6/C9+PID调试A1/A2/A5)
    [joint_motor_command_list.csv]
2026-08-07 build(keil): 更新编译分析结果(新增motor_observer后Flash/RAM占用)
    [JointMotorApp_analysis.xlsx, JointMotorApp_sort_by_flash.csv, JointMotorApp_sort_by_ram.csv]
2026-08-07 feat(trace): 高速波形重构为连续TRACE流(0xB9/0xBA环形缓冲主动上报,废弃B7/B6/C9)
2026-08-07 docs(protocol): 更新TRACE协议文档与命令清单(0xB9/0xBA,废弃B5~B7/C9波形)
    [joint_motor_command_list.csv]
2026-08-07 build(keil): 更新编译分析结果(TRACE重构后Flash/RAM占用)
    [JointMotorApp_analysis.xlsx, JointMotorApp_sort_by_flash.csv, JointMotorApp_sort_by_ram.csv]
2026-08-07 feat(cleanup): 删除VESC/SerialStudio通信模块并清理冗余注释与死代码
    废弃 VESC Tool 兼容链路与 SerialStudio 上位机配置: 删除 dev_commun_vesc/vesc_proto/serial_studio 模块及 thread_commun 中相关初始化与轮询，精简代码文件头注释、移除死代码与占位实现(vofa/check_loss/fault_check 等)
2026-08-07 docs+build: 更新readme与协议文档并移除Keil工程VESC引用
    readme 与 joint_proto 逻辑关系图移除 VESC/SerialStudio 引用，Keil 工程头文件路径删除 vesc_proto
2026-08-10 chore: 同步pyqt_gui子模块并清理本地计划文档
    更新子模块指针至TRACE主动波形适配版本(f9f851b/340c424); 删除User/Data下plans/html_modes本地文档并加入.gitignore; jm_cmd_def.h注释对齐; 版本升至1.1.5
2026-08-14 feat(eeprom): motor_info片外EEPROM双备份存储与Flash磨损均衡保护
    新增AT24C16片外EEPROM双备份(上电优先加载, 0xEA固化Flash+EEPROM双写); motor_info增加flash_write_count字段与写入次数超限保护; 协议新增EEPROM/写限错误码(0x14/0x15/0x16); 新增SFOC_V2板级支持(子模块+board_select); 同步pyqt_gui固化通知与motor_info生成器; 版本升至1.2.0
    [JointMotorApp_analysis.xlsx, JointMotorApp_sort_by_flash.csv, motor_info.csv]
2026-08-14 feat(eeprom): V1板接入EEPROM存储并完善存储介质控制
    - V1板: dev_config_board.h启用USE_DEV_EEPROM, inc配置MB85RC16(I2C1 PA15/SCL, PB9/SDA), Keil工程加入dev_eeprom.c
    - 0xEA固化增加flags存储介质控制: 默认仅写EEPROM(上电优先加载), bit0(FLASH)追加写Flash备份
    - flash_write_count语义调整为save_count(固化总次数), 每次固化自增, 超限返回ERR_SAVE_LIMIT
    - 协议层新增JM_MOTOR_INFO_SAVE_FLAG_FLASH标志, 错误码JM_ERR_SAVE_LIMIT重命名及映射更新
    [joint_motor_command_list.csv, motor_info.csv]
2026-08-14 chore(pyqt_gui): 同步上位机存储介质控制与固化UI优化
2026-08-14 feat(motor): 电机功率级使能配置表化(USE_DEV_MOTOR, PB12)
    - V1板: 新增USE_DEV_MOTOR宏, motor_enable_list移入dev_config_board.inc配置表(PB12高电平使能)
    - dev_motor.c: enable/disable按USE_DEV_MOTOR门控, 无EN功能板(SFOC/SFOC_V2)为空操作
    - dev_config.c引入dev_motor.h, 统一板级配置装配
2026-08-18 refactor(foc): SVPWM热路径重构与PLL带宽调整
    - foc_svpwm改用局部变量运算+clamp_vector_time, 零电压指令提前处理直接输出零矢量(扇区0异常兜底)
    - foc_init建立sin/cos缓存不变式(Theta=0,cos=1), 修复首拍电角度为0时Park/逆Park输出全零
    - PLL默认带宽150Hz->100Hz, 兼顾跟随性与噪声抑制
    [foc_core.c, foc_core.h, motion_param.c]
2026-08-18 feat(config): 新增RS03关节电机profile并设为默认
    - 依据RS03说明书260428参数: 额定500W/1500rpm/3.183Nm/DC48V/极对数8
    - 磁链由KT反算(flux=KT/(1.5*pp)), 修正说明书标称值与额定转矩不自洽问题
    [motor_profile.h]
2026-08-18 chore(project): 同步V1工程配置构建产物与通讯实时性文档
    - V1 Keil工程调试配置(uvoptx)与构建分析产物(alog/xlsx/sort_by_*)更新
    - 通讯实时性评估文档: 电流环周期20kHz->10kHz修正占比结论
    [JointMotorApp_analysis.xlsx, JointMotorApp_sort_by_flash.csv, JointMotorApp_sort_by_ram.csv]
2026-08-20 feat(sweep): 新增Bode扫频测试(0x76整数载荷+TRACE高速上传) v1.3.0
    - 0x76 TEST_SWEEP_FREQ 重构为偏置扫频12B整数载荷(control/point_cfg/起止频率/幅值/偏置/格式标签), 支持力矩vs速度/电流vs速度/电流vs电流/速度vs位置/速度vs速度/位置vs位置6种模式; 协议版本升至1.4
    - motor_control 新增扫频状态机(MOTOR_SWEEP_STATE_IDLE/SETTLE/MEASURE/DONE/ABORTED)与1024点相位/频率查表; 多圈零点复位接口
    - motor_observer TRACE 缓冲扩展至512样本, 新增SWEEP/POINT_START/POINT_END标志, finish/is_busy接口; UART链路单周期4包排空支撑2k~10kHz采样
    - system_state 扫频直接进入RUN子状态与故障中止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
    [joint_motor_command_list.csv]
2026-08-20 fix(motor): 修复MKS5010电机电气参数数量级错误 v1.3.1
    - flux/KT/KE 由 3.79e-5/0.398e-3/2.65e-4 修正为 3.79e-3/0.0398/0.0265(放大100倍)
    - 原KT偏小100倍致力矩模式 iq=τ/KT 被放大100倍(0.01Nm即25A), 现象为母线被拉垮
    - 增加24V空载转速自洽校验(KV法反算), 默认profile切回5010_360
    [motor_profile.h, version.h]
2026-08-20 chore(build): 更新V1工程构建分析产物与新SVPWM/IPB参数
    - 同步扫频测试编译后的Flash/RAM占用与资源分析(alog/xlsx/sort_by_*)
    - drv_config.h 注释 USE_I2C_DRIVER 宏(EEPROM 现经 dev_config_board 表驱动)
    - user_interface.c 精简单行注释占位
    [JointMotorApp_analysis.xlsx, JointMotorApp_sort_by_flash.csv, JointMotorApp_sort_by_ram.csv]
2026-08-20 chore(pyqt_gui): 同步上位机子模块至feat_bode Bode扫频版本
    上位机升级至 1.2.0(协议适配0x76扫频+TRACE标志), 新增Bode扫频UI/分析/会话管理与MKS5010配置。
2026-08-24 fix(state): 补回对拖台负载模式的三处丢失修改, 修复0x60僵尸态
    system_state.c 曾被意外回退, 导致 0x60~0x67 映射表条目丢失:
    s_ctrl_mode_to_run_state[0x60] 未初始化=0(IDLE), 发 0x60 后进入
    top=RUN + run_state=IDLE + ref=IDLE 僵尸态, 电流环走 IDLE 分支,
    PWM 置零且三相电流停止采样。
    补回内容:
    - 映射表 8 个对拖条目 (CONTROL_MODE_PASSIVE_TORQUE~IMPACT_LOAD)
    - run_state_switch 负载模式进入时调用 motor_load_sim_reset
    - motor_mode.h include
    [system_state.c]
2026-08-24 feat(load-sim): 新增对拖台负载模拟(0x60~0x67)与零力模式 v1.4.0
    协议1.4->1.5: 新增被动恒转矩/动态转矩/平方负载/恒功率/摩擦/惯量/工况谱/冲击过载8种负载模拟命令段与LOAD_SIM特性位; 零力模式独立实现; motor_load_sim_t参数+运行时状态内聚挂载motor_ctrl_t; TRACE链路重构(UART主走/CAN兜底); 调试通道增转矩参考; 板级电机选型motor_config_board.h; 协议次版本升级。
    [joint_motor_command_list.csv, motor_param.csv]
2026-08-24 refactor(motor-select): 电机选型下沉为板级motor_config_board.h
    型号选择从motor_profile.h的MOTOR_PROFILE移动至各板Config/motor_config_board.h的MOTOR_PROFILE_BOARD(由board_select.h分发), 未指定板由motor_profile.h兜底为GM4820H; 增加编译期非法型号校验; V1板配置为RS03对拖台电机。
2026-08-24 chore(build): 更新V1工程构建产物并使能I2C驱动
    同步ALog/Flash-RAM占用分析/构建日志【含新增load_sim与zero_force源码】; drv_config.h使能I2C驱动。
    [JointMotorApp_analysis.xlsx, JointMotorApp_sort_by_flash.csv, JointMotorApp_sort_by_ram.csv]
2026-08-24 chore(pyqt_gui): 同步上位机子模块至 1.3.0 (负载模拟+tester形态)
    - 0x60~0x67 负载模拟命令段/RunState 重编号(协议不兼容, 1.2.0→1.3.0)
    - 测试员应用形态 profile 裁剪 + TesterMainWindow
    - 运动模式白名单 motion_modes.txt 与状态机图负载段
    - 虚拟引擎被动恒转矩孪生/Bode 粘滞标志判定修复/RS03 配置
2026-08-25 feat(calib): L2.1相序识别重构为开环旋转平均法, 持久化 enc_direction v1.4.1
    - 相序识别改开环正向扫描N电周期, 累计编码器原始角整周平均判定方向(对offset/dir免疫, 消除自证)
    - 判定结果写回 encoder_direction 与 motor_info.direction(index 19), 新增 motor_info_calib_submit_direction 接口
    - 幅度校验(|累计角|≥理论半周)判堵转, 方向经 calib_validate_enc_direction 校验
    - 同步标定配置: 移除旧300ms步进, 新增扫描电周期数2; patch 1.4.0→1.4.1
2026-08-25 chore(docs): 同步电机参数表注释措辞与 V1 构建产物(L2.1 后)
    [JointMotorApp_analysis.xlsx, JointMotorApp_sort_by_flash.csv, JointMotorApp_sort_by_ram.csv, motor_info.csv]
2026-08-27 feat(sweep): TRACE采样率逐频点钳制防溢出, 新增实测电流→速度模式6 v1.4.2
    - motor_observer: 新增 trace_set_rate 运行中动态调采样率; 包头按频点实际记录速率打包(不再读全局); 载荷上限按通道数钳制包长防缓冲僵死
    - sweep_load_point: 逐频点将 TRACE 采样率钳到 20f~会话起始率, 512 深缓冲防溢出丢样
    - 新增方向一模式6(实测电流→速度): 高频段电流环跟不上目标时仍反映真正进机械对象的电流, 谐振/带宽测量不受污染
    - 配置接口增 trace_rate_min/start; patch 1.4.1→1.4.2
2026-08-27 fix(board/V1): 修正ADC触发点(CCR 200→20)与CAN宏注释对齐
    - HALF_BRIDGE_ADC_TRIG_CCR 200→20: 与实际采样窗口匹配
    - dev_config_board.h 各配置宏注释格式对齐
    [dev_config_board.h]
2026-08-27 build(V1): 更新构建产物(扫频TRACE钳制+模式6后)
    [JointMotorApp_analysis.xlsx, JointMotorApp_sort_by_flash.csv, JointMotorApp_sort_by_ram.csv]
2026-08-27 chore(gitignore): 忽略本地 SimpleGUI 开发目录
2026-08-27 docs: 新增标定体系优化方案与扫频/波特图技术文档
    - 标定体系: 电机电气参数标定方案文档
    - 扫频: 开环波特图设计、扫频测试原理与模式知识、下位机功能状态统计
2026-08-27 chore(submodules): 同步 4 个子仓库指针至功能/修复/build 提交
    - ODriveMKS: 使能电机功率级 USE_DEV_MOTOR + build
    - SFOC: 清理 VESC 死代码 + build
    - SFOC_V2: 死区/ADC 修复, 新增电机选型 + build
    - pyqt_gui: Bode 双估计器/模式6/协议适配/UI/config v1.3.1
2026-08-27 feat(protocol): 新增0x07 SOFT_RESET上位机命令软件复位(协议1.6)
    - jm_cmd_def.h: 命令码0x07+魔数0x5E7E7E5E防误触, 协议版本1.5→1.6
    - jm_proto_ops.c: app_soft_reset校验魔数后安全停机(RUN→READY→IDLE), ACK先行延迟200ms由jm_app_soft_reset_poll执行NVIC_SystemReset, 保证ACK/DMA发送完成且停机电流衰减
    - jm_proto.c: dispatch专用分支(不走set_mode), CAN广播不开放
    - jm_host_commun.c: UART/CAN双通道挂载复位poll
    - 修复0xB2 ENTER_BOOTLOADER不校验magic的隐患, 补NACK(UNAUTHORIZED)
    - 同步命令表csv/dbc/gen_can_dbc.py/protocol_spec.md
    [joint_motor_command_list.csv]
2026-08-27 chore(submodules): 同步pyqt_gui指针至0x07软件复位支持(e3902ab)
2026-08-27 chore(submodules): 同步pyqt_gui指针至功率监控Tab(3eece07)
2026-08-28 chore(submodules): 同步pyqt_gui指针至功率监控后台运行(600e596)
2026-09-02 feat(calib): L6惯量辨识与PID自整定落地, 磁链死区实测派生修正, 交流注入相敏解算修复 (v1.4.3)
    - L6.1 双向恒流加速法辨识轴系转动惯量(自适应电流/运动触发采样窗), L6.4 复用 motor_pid_autotune 整定并落盘 rotor_inertia
    - 磁链标定: 死区电压改为 t_dt*f_pwm*Vbus 实测派生(替代固定0.75V, 修复48V母线flux读数压低44%), 标定期间关闭运行期死区补偿防重复计账, 稳态方程补扣 ωe*Ld*id 项
    - 交流注入: 相敏解算改为对 sin/cos 直接正交分解(修复 R/Ld 互换), 参考相位补偿采样链延迟, 注入频率取 ωL=R(φ=45°)最大化感性分量信噪比, 采样窗口整周期量化, 平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
    [calib_ac_injection.c, calib_ac_injection.h, calib_config.h, calib_config_runtime.c, calib_config_runtime.h, calib_level2_motor.c, calib_level6_system.c, calib_validate.h]
2026-09-02 feat(power): NTC温度解算——查表+线性插值+钳制+LPF, V1启用驱动/电机两通道(10k/100k分度表板级可选)
    - 新增 pm_ntc_voltage_to_temp: 按接地侧电阻还原NTC阻值, 分度表线性插值, 开路/短路边界钳制
    - 内置 10k(-40~125℃) 与 100k(领技CA-NTC24C018, -30~230℃) 两张分度表, 板级经 ntc_table 字段选用
    - TEMP_DRIVER/MOTOR/MCU 通道统一 pm_update_temp(查表+一阶LPF), scale>0 启用; SFOC_V2 等未填 scale 行为不变
    - V1 板配置: NTC_FET(10k默认表)→驱动器温度, NTC_MOT(100k表)→电机温度
    - dev_config.h 新增 PM_NTC_PULLDOWN_KOHM / PM_TEMP_LPF_ALPHA 配置项
2026-09-02 feat(board/V1): 台架电机由RS03切换为强和QH8919, motor_info表字段标注物理符号
    - motor_profile.h 新增 MOTOR_PROFILE_QH8919: 实测标定参数(48V/pp14/1.6Nm), KT与flux自洽校验
    - motor_config_board.h: MOTOR_PROFILE_BOARD 切到 QH8919
    - motor_info_gen 参数表: 字段名追加物理符号(Rs/Ld/ψf/Kt/J/i/ωc等), 便于上位机与文档对齐
    [motor_info.csv]
2026-09-02 feat(ctrl): 参考渐变支持S曲线与切环数值渐变, ISR分段耗时打点, 电角度刷新去重
    - ctrl_transition: 新增 shape 字段(LINEAR/SCURVE smoothstep), 切环时数值字段仍按形状渐变消除给定阶跃; rate模式按峰值斜率×1.5补偿时长
    - motor_loop: 按 vel/pos 拍去重电角度刷新(解算拍内已刷新), 编码器角度归一化改一次取整替代fmodf
    - ISR 分段耗时打点: 编码器/反馈解算/外环/观察者/电流环细分(PI解耦 vs SVPWM), 经 DWT 计数器观测
2026-09-02 perf(mt6835): 角度读取改连续读单帧(3次单字节读→1帧6字节), SPI寄存器直操作快速收发
    - dev_mt6835: 0xA0连续读命令一帧回读ANGLE3/2/1+CRC, 消除3次独立读间的角度撕烈(37us→约12us)
    - drv_spi: 新增 drv_spi_transfer_fast 寄存器直操作(绕过HAL状态机, FIFO交错收发+轮询上限防死锁), 入口幂等补齐SPE/FRXTH
2026-09-02 perf(board/V1): Flash预取与指令/数据缓存使能, 提升代码执行效率
2026-09-02 build(V1): 重新构建更新MDK产物, 版本号BUILD位递增至1 (v1.4.3.1)
    [JointMotorApp_analysis.xlsx, JointMotorApp_sort_by_flash.csv, JointMotorApp_sort_by_ram.csv]
2026-09-02 chore(gitignore): 忽略构建日志(*.log)与本地开发目录(.workbuddy/.archify/.pytest_cache)
2026-09-02 chore(submodules): 同步SFOC_V2构建产物与pyqt_gui功率监控增强指针(b0bbf54/0af3f8d)
2026-09-07 删除子模块 Board/SFOC
    [JointMotorApp_analysis.xlsx, JointMotorApp_sort_by_flash.csv, JointMotorApp_sort_by_ram.csv]
2026-09-10 feat(fault): 新增FaultManager分级故障管理, 协议升至1.12 (v1.6.0)
    - 故障码表(0xSLNN分级)与fault_param生成器, 快/慢双路检测
    - 三级使能掩码(故障/异常/警告)总开关, 0xAA/0xAB/0xAC故障诊断, 0xB0清障扩展
    - 协议1.12: 0xE6/0xE7按类型定长, 预留JM_PT_U64, 0xED固化清零, 0xAD/0xAE废弃
    - 0xA3/0xA4缓启动渐变配置读写(运行时生效+镜像motor_info)
    - 编码器健康/错误计数接口, 电源温度通道, 软限位钳制与降功率联动
    - Keil工程登记FaultManager源组并接入incr_build.py
    [fault_param.csv, joint_motor_command_list.csv]
2026-09-10 feat(param): motor_info/motor_param 参数系统重构, 生成器+存储裁剪 (v1.7.0)
    - motor_info/motor_param 生成器重构: CSV 驱动生成, MOTOR_INFO_EN_/MOTOR_PARAM_EN_ 裁剪宏默认关
    - protect_enable 总使能+三级使能掩码(低/高32对)融合 ProtectComm, FaultParam 块取消, 配置版本5
    - u32_bool 参数类型/JM_PT_U64 支持, EEPROM 回读校验修复(防假ACK), Flash备份开关
    - motor_profile 标定默认值兜底(pwm_freq/dead_time/补偿增益), adc/assert 裁剪
    [motor_info.csv, motor_param.csv]
2026-09-10 feat(ctrl): 电流环FOC补偿诊断与观测器/ADC优化 (v1.8.0)
    - 电流环补偿诊断快照(交叉解耦/反电势/补偿后ud/uq)入调试通道, CAN路径同步刷新
    - FOC解耦/前馈/死区参数板级回退与运行时非零保证, 反电势项独立诊断
    - ADC注入组EOC序列化修复(JEOS一次触发)与IT模式启动
    - motor_observer大缓冲按需放CCM-SRAM(默认启用释放主RAM约28K)
    - 电机极对数字段注标定加载, L5采样计数uint32防回绕, 编码器健康/坏帧差分
    - 扫频TRACE缓冲与包头上限重构, 软限位钳制
    [JointMotorApp.ioc, calib_level5_nonlinear.c, cascade_control.c, ctrl_transition_mgr.c, ctrl_transition_mgr.h, current_loop.c, current_loop.h]
2026-09-10 build(tools): 新增incr_build版本自增脚本, 清理方案文档与规范 (v2.0.0)
    - incr_build.py 编译前版本号自动递增, Keil工程接入(主版本升级)
    - gen_can_dbc 同步命令清单, clang-format 行宽200, gitignore 忽略构建产物
    - 清理MotorControl过期设计方案文档(对拖台/开环波德/扫频原理/状态表)
    - uvprojx 登记FaultManager源组与RAM/CCM布局调整
2026-09-10 chore(submodules): 同步pyqt_gui指针至协议1.12/故障/软启动适配(f87eb23)
2026-09-18 基线版本v1.0.0
    - feat: 新增齿槽/摩擦补偿、故障管理优化与代码重构
    1. 新增齿槽转矩补偿与摩擦前馈补偿算法模块
    2. 优化电机环调度策略与位置环死区抑制
    3. 更新故障管理配置与故障码表
    4. 重构DWT打点命名与LED驱动支持RGB灯
    5. 调整PLL带宽与版本号，扩展Flash分区
    6. 新增电机参数同步与配置版本升级
    [JointMotorApp_analysis.xlsx, JointMotorApp_sort_by_flash.csv, JointMotorApp_sort_by_ram.csv, fault_param.csv, motor_info.csv]
